ubi-naist/SenStick/ios/SenStickViewer/17091211_1349649568406678_518194324_o.jpg

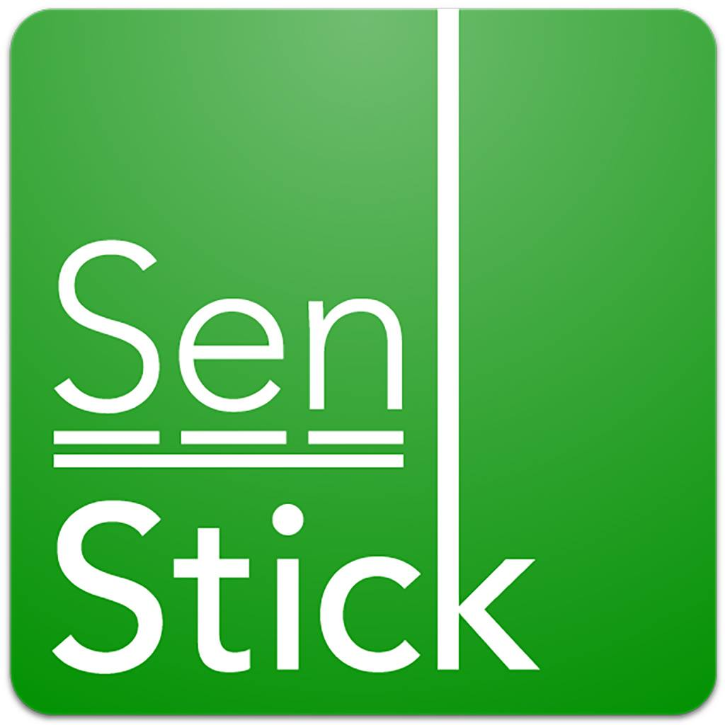
ios/SenStickViewer/17091211_1349649568406678_518194324_o.jpg
