ubi-naist/SenStick/docs/nRF52_SenStick_ハードウェア資料/PWB確認_02.pptx

SenStick3外形寸法

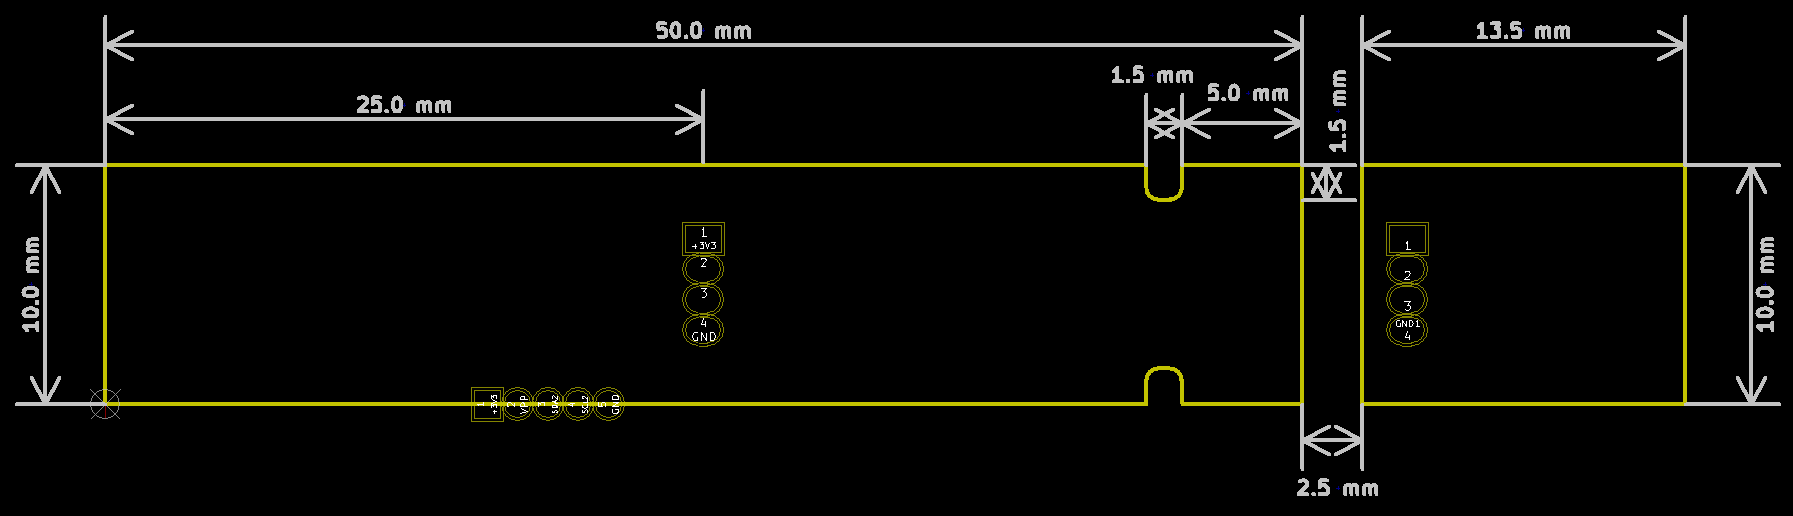
[picture p2: figure]

## Slide 2

SenStick3　全層パターン図

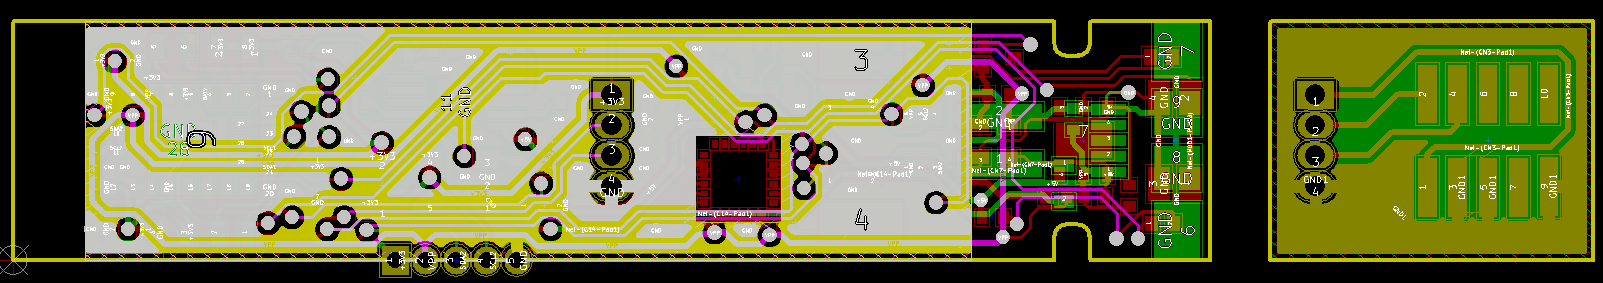
[picture p3: figure]

9軸センサー

温湿度センサー

## Slide 3

SenStick3パターン図

L1:表面

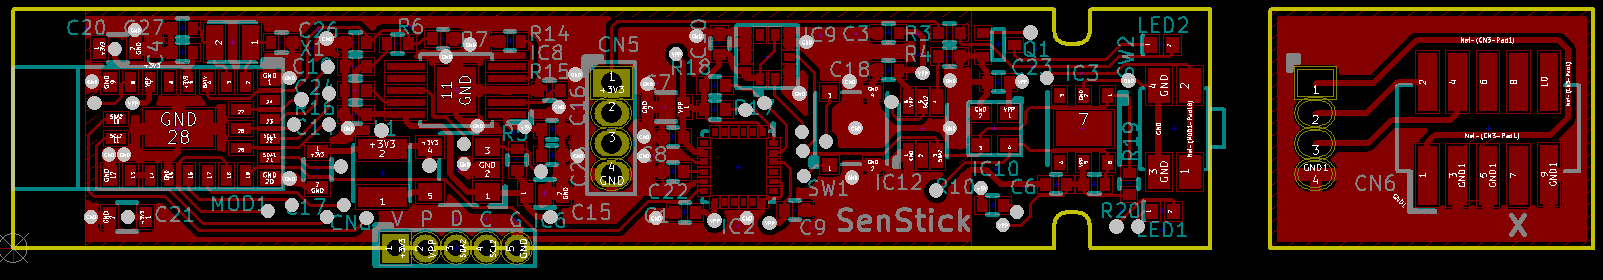
[picture p4: figure]

シルク文字:SenStick　Ver.3 Rev.00

シルク文字:SenStick

L4:裏面

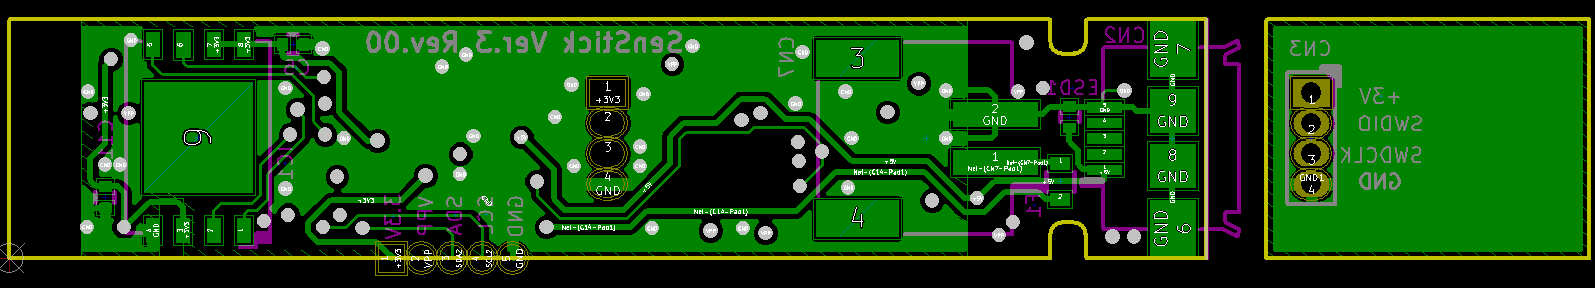
[picture p5: figure]

## Slide 4

SenStick3パターン図

L2:内層(GND)

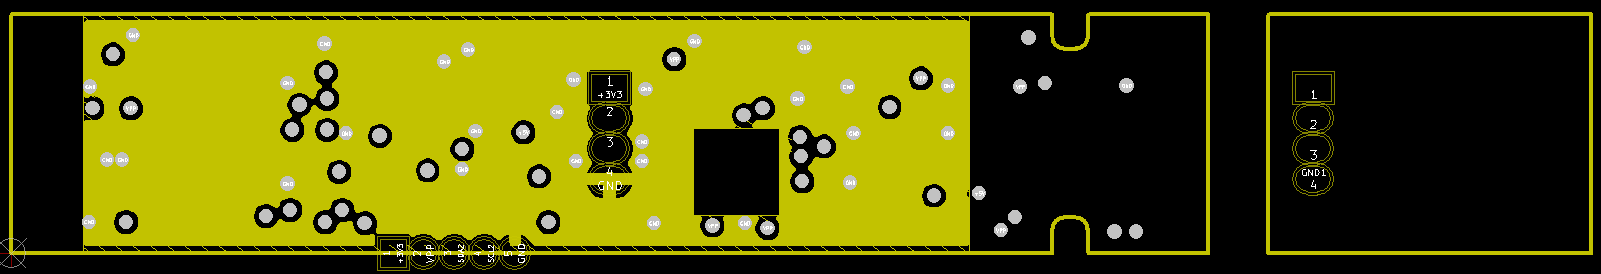
[picture p6: figure]
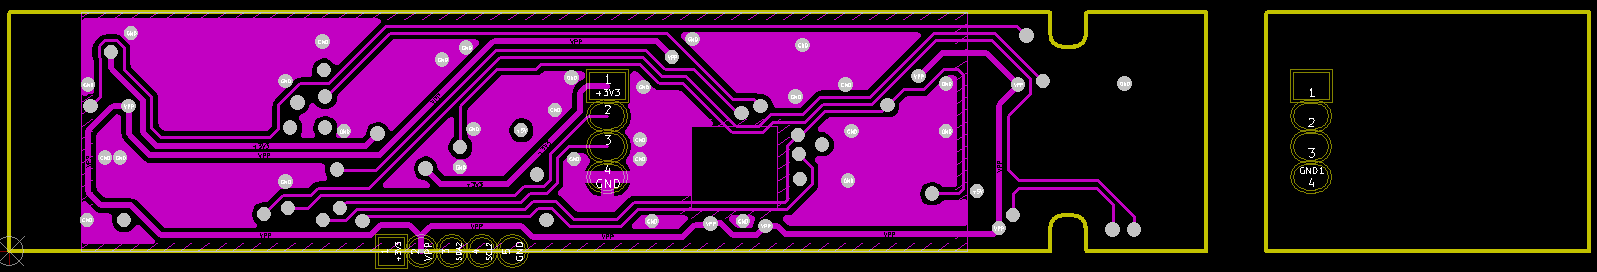
[picture p7: figure]

L3:内層(GND+信号線)
