ubi-naist/SenStick/ios/SenStickViewer/README.md

ビルド時にエラーメッセージが出ます。

'/Users/T_Suzuki/Desktop/Matilde/_arart/_senstick/0704/SenStickViewer/Pods/Target Support Files/EVReflection/EVReflection-prefix.pch' file not found

次のコマンドを実行してください。

$ cd SenStick-firmware/ios/SenStickViewer
$ pod install
