ubi-naist/SenStick/3d_data/case/senstick2/101.Glasses/README.pdf

●3D データ利用に関する注意

この SenStick2 用のメガネケースのメガネの元の 3D データは i.Design Studio が提

供して いるものです。使用(対外的に公開(学会や論文誌等))する際は i.Design Studio

のクレジット を表記してください。

利用に関する詳細は下記サイトを参照してください。
http://www.idesign-s.com/info/eyewear-3d-data/

以上

作成者：金平卓也
作成日：2016/08/09

バージョン：1.00
