ubi-naist/SenStick/docs/nRF52_SenStick_ハードウェア資料/Senstick3_BOM_R00.xlsx

Loc. | Symbol | Footprint | 品名 | 概要 | Sche | 単価 | SIZE | 記事 | QFP | CHIP | DISC
MOD1 | EYSHJNZXZ | EYSHJNZXZ | EYSHJNZXZ | BLE module | EYSHJNZXZ | 1713.1 | 11.3x5.1x1.3 |  | 1 |  |  | http://www.mouser.jp/ProductDetail/Taiyo-Yuden/EYSHJNZXZ/
IC1 | MX25L25635FZ2 | WSON-8L | MX25L25635FZ2I-10G | Flash 256M | MX25L25635FZ2 | 423.6 | 10x10x2.65 |  | 1 |  |  | http://www.digikey.jp/product-detail/ja/macronix/MX25L25635FZ2I-10G/1092-1150-ND/4211591
IC2 | MPU-9250 | MPU-9250 | MPU-9250 | 9D Sensor | MPU-9250 | 655.6 | 3x3x1.1 |  | 1 |  |  | http://www.digikey.jp/product-detail/ja/invensense/MPU-9250/1428-1019-1-ND/4626450
IC3 | SHT-20 | SHT-20 | SHT20 | Tenp/Hum Sensor | SHT-20 | 484.7 | 3x3x1.1 |  | 1 |  |  | http://www.digikey.jp/product-detail/ja/sensirion-ag/SHT20/1649-1004-1-ND/5872286
IC6 | XC9265331MR-G | SOT-25 | XC9265A331MR-G | DC/DC 3.3V | XC9265331MR-G | 110.8 | 2.9x2.8 |  | 1 |  |  | http://www.digikey.jp/product-search/ja/integrated-circuits-ics/pmic-voltage-regulators-dc-dc-switching-regulators/2556570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
IC8 | BQ24090 | HVSSOP10 | BQ24090DGQR | Li-po Charger | BQ24090DGQR | 93.7 | 5x3 |  |  | 1 |  | http://www.digikey.jp/product-detail/ja/texas-instruments/BQ24090DGQR/296-38875-1-ND/5142987
IC9 | LPS25 | HLGA-10L | LPS25HBTR | Pressure Sensors | LPS25HBTR | 276.5 | 2.5x2.5x0.8 |  | 1 |  |  | http://www.mouser.jp/ProductDetail/STMicroelectronics/LPS25HBTR/
IC10 | BH1780 | BH1780 | BH1780GLI-E2 | Light Sensor | BH1780GLI-E2 | 231.1 | 2x2x0.8 |  | 1 |  |  | http://www.mouser.jp/ProductDetail/ROHM-Semiconductor/BH1780GLI-E2/
IC12 | VEML6070 | VEML6070 | VEML6070 | UV Sensor | VEML6070 | 138.2 | 2.35x1.8 |  | 1 |  |  | http://www.mouser.jp/ProductDetail/Vishay/VEML6070/
Q1 | DTC123E | SOT523 | DDTC123EE-7-F | Digi Tr. | DTC123E | 19.8 | 1.6x1.6 |  |  | 1 |  | http://www.digikey.jp/product-detail/ja/diodes-incorporated/DDTC123EE-7-F/DDTC123EE-FDICT-ND/815591
LED1 | LED | SML-P1 | SML-P13BC8TT86 | Blue | Blue | 22.7 | 1x0.6 | 充電中 |  | 1 |  | http://www.mouser.jp/ProductDetail/ROHM-Semiconductor/SMLP13BC8TT86/
LED2 | LED | SML-P1 | SML-P12VTT86R | Red | Red | 12.9 | 1x0.6 | 動作中 |  | 1 |  | http://www.mouser.jp/ProductDetail/ROHM-Semiconductor/SML-P12VTT86R/
ESD1 | TVS | CR1005 | LXES15AAA1-100 | LXES15AAA1-100 | LXES15AAA1 | 42.0 | 1005 | Vbus用 |  | 1 |  | http://www.digikey.jp/product-detail/ja/murata-electronics-north-america/LXES15AAA1-100/490-5680-1-ND/2651839
X1 | Crystal | FC-12M | FC-12M 32.7680KA-A3 | 32.768kHz 20ppm | 32.768kHz | 65.8 | 2.05x1.2 | 推奨部品 |  | 1 |  | http://www.digikey.jp/product-detail/ja/epson/FC-12M-32.7680KA-A3/SER3672CT-ND/2403445
L1 | INDUCTOR | DFE2520 | 1239AS-H-100M=P2 | 10uH | 10u | 27.4 | 2.5x2x1.2 |  |  | 1 |  | http://www.mouser.jp/ProductDetail/Murata/1239AS-H-100M=P2/
F1 | FUSE | CR1608 | FMC16102ABTP | 1A | 1A | 16.9 | 1608 |  |  | 1 |  | http://www.mouser.jp/ProductDetail/Walsin/FMC16102ABTP/
R3 | R | CR1005 | ERJ-2RKF1001X | 1k | 1k | 1.2 | 1005 |  |  | 1 |  | http://www.digikey.jp/product-detail/ja/panasonic-electronic-components/ERJ-2RKF1001X/P1.00KLCT-ND/97341
R4 | R | CR1005 | ERJ-2RKF5603X | 560k | 560k | 1.2 | 1005 |  |  | 1 |  | http://www.digikey.jp/product-detail/ja/panasonic-electronic-components/ERJ-2RKF5603X/P560KLCT-ND/1746704
R5 | R | CR1005 | ERJ-2RKF1003X | 100k | 100k | 1.2 | 1005 |  |  | 1 |  | http://www.digikey.jp/product-detail/ja/panasonic-electronic-components/ERJ-2RKF1003X/P100KLCT-ND/194127
R6 | R | CR1005 | ERJ-2RKF4703X | 470k | 470k | 1.2 | 1005 |  |  | 1 |  | http://www.digikey.jp/product-detail/ja/panasonic-electronic-components/ERJ-2RKF4703X/P470KLCT-ND/1746694
R7 | R | CR1005 | ERJ-2RKF2203X | 220k | 220k | 1.2 | 1005 |  |  | 1 |  | http://www.digikey.jp/product-detail/ja/panasonic-electronic-components/ERJ-2RKF2203X/P220KLCT-ND/1746654
R10 | R | CR1005 | ERJ-2RKF1001X | 1k | 1k | 1.2 | 1005 |  |  | 1 |  | http://www.digikey.jp/product-detail/ja/panasonic-electronic-components/ERJ-2RKF1001X/P1.00KLCT-ND/97341
R14 | R | CR1005 | ERJ-2RKF2001X | 2k | 2k | 1.2 | 1005 |  |  | 1 |  | http://www.digikey.jp/product-detail/ja/panasonic-electronic-components/ERJ-2RKF2001X/P2.00KLCT-ND/194233
R15 | R | CR1005 | ERJ-2RKF2202X | 22k | 22k | 1.2 | 1005 |  |  | 1 |  | http://www.digikey.jp/product-detail/ja/panasonic-electronic-components/ERJ-2RKF2202X/P22.0KLCT-ND/1746653
R16 | R | CR1005 | ERJ-2RKF1002X | 10k | 10k | 1.2 | 1005 |  |  | 1 |  | http://www.digikey.jp/product-detail/ja/panasonic-electronic-components/ERJ-2RKF1002X/P10.0KLCT-ND/194119
R17 | R | CR1005 | ERJ-2RKF1002X | 10k | 10k | 1.2 | 1005 | I2C Pullup |  | 1 |  | http://www.digikey.jp/product-detail/ja/panasonic-electronic-components/ERJ-2RKF1002X/P10.0KLCT-ND/194119
R18 | R | CR1005 | ERJ-2RKF1002X | 10k | 10k | 1.2 | 1005 | I2C Pullup |  | 1 |  | http://www.digikey.jp/product-detail/ja/panasonic-electronic-components/ERJ-2RKF1002X/P10.0KLCT-ND/194119
R19 | R | CR1005 | ERJ-2RKF1002X | 10k | 10k | 1.2 | 1005 | I2C Pullup |  | 1 |  | http://www.digikey.jp/product-detail/ja/panasonic-electronic-components/ERJ-2RKF1002X/P10.0KLCT-ND/194119
R20 | R | CR1005 | ERJ-2RKF1002X | 10k | 10k | 1.2 | 1005 | I2C Pullup |  | 1 |  | http://www.digikey.jp/product-detail/ja/panasonic-electronic-components/ERJ-2RKF1002X/P10.0KLCT-ND/194119
C1 | C | CR1005 | GRM155R71C104KA88J | 0.1uF | 0.1u | 0.6 | 1005 |  |  | 1 |  | http://www.digikey.jp/product-detail/ja/murata-electronics-north-america/GRM155R71C104KA88J/490-6328-1-ND/3845525
C3 | C | CR1005 | GRM155R71C104KA88J | 0.1uF | 0.1u | 0.6 | 1005 |  |  | 1 |  | http://www.digikey.jp/product-detail/ja/murata-electronics-north-america/GRM155R71C104KA88J/490-6328-1-ND/3845525
C4 | C | CR1005 | GRM155R71C104KA88J | 0.1uF | 0.1u | 0.6 | 1005 |  |  | 1 |  | http://www.digikey.jp/product-detail/ja/murata-electronics-north-america/GRM155R71C104KA88J/490-6328-1-ND/3845525
C5 | C | CR1005 | GRM155R71C104KA88J | 0.1uF | 0.1u | 0.6 | 1005 |  |  | 1 |  | http://www.digikey.jp/product-detail/ja/murata-electronics-north-america/GRM155R71C104KA88J/490-6328-1-ND/3845525
C6 | C | CR1005 | GRM155R71C104KA88J | 0.1uF | 0.1u | 0.6 | 1005 |  |  | 1 |  | http://www.digikey.jp/product-detail/ja/murata-electronics-north-america/GRM155R71C104KA88J/490-6328-1-ND/3845525
C7 | C | CR1608 | GRM188R60J106ME47J | 10uF | 10u | 5.5 | 1608 |  |  | 1 |  | http://www.digikey.jp/product-detail/ja/murata-electronics-north-america/GRM188R60J106ME47J/490-6405-1-ND/3845602
C8 | C | CR1005 | GRM155R60J475ME47D | 4.7uF/6.3V | 4.7u | 5.0 | 1005 |  |  | 1 |  | http://www.digikey.jp/product-detail/ja/murata-electronics-north-america/GRM155R60J475ME47D/490-5915-1-ND/3719860
C9 | C | CR1005 | GRM155R71C104KA88J | 0.1uF | 0.1u | 0.6 | 1005 |  |  | 1 |  | http://www.digikey.jp/product-detail/ja/murata-electronics-north-america/GRM155R71C104KA88J/490-6328-1-ND/3845525
C10 | C | CR1005 | GRM155R60J105KE19D | 1uF/6.3V | 1u | 1.1 | 1005 |  |  | 1 |  | http://www.digikey.jp/product-detail/ja/murata-electronics-north-america/GRM155R60J105KE19D/490-1320-1-ND/587919
C11 | C | CR1005 | GRM155R60J475ME47D | 4.7uF/6.3V | 4.7u | 5.0 | 1005 |  |  | 1 |  | http://www.digikey.jp/product-detail/ja/murata-electronics-north-america/GRM155R60J475ME47D/490-5915-1-ND/3719860
C14 | C | CR1005 | GRM188R60J226MEA0D | 2.2uF | 2.2u | 10.2 | 1005 |  |  | 1 |  | http://www.digikey.jp/product-detail/ja/murata-electronics-north-america/GRM155R61A225KE95D/490-10451-1-ND/5026361
C15 | C | CR1608 | GRM188R60J106ME47J | 10uF | 10u | 5.5 | 1608 |  |  | 1 |  | http://www.digikey.jp/product-detail/ja/murata-electronics-north-america/GRM188R60J106ME47J/490-6405-1-ND/3845602
C16 | C | CR1005 | GRM155R71C104KA88J | 0.1uF | 0.1u | 0.6 | 1005 |  |  | 1 |  | http://www.digikey.jp/product-detail/ja/murata-electronics-north-america/GRM155R71C104KA88J/490-6328-1-ND/3845525
C17 | C | CR1608 | GRM188R60J226MEA0D | 22uF | 22u | 10.2 | 1608 |  |  | 1 |  | http://www.digikey.jp/product-detail/ja/murata-electronics-north-america/GRM188R60J226MEA0D/490-7611-1-ND/4280544
C18 | C | CR1005 | GRM155R71C104KA88J | 0.1uF | 0.1u | 0.6 | 1005 |  |  | 1 |  | http://www.digikey.jp/product-detail/ja/murata-electronics-north-america/GRM155R71C104KA88J/490-6328-1-ND/3845525
C19 | C | CR1005 | GRM155R71H103KA88D | 0.01uF | 0.01u | 0.5 | 1005 |  |  | 1 |  | http://www.digikey.jp/product-detail/ja/murata-electronics-north-america/GRM155R71H103KA88D/490-4516-1-ND/1033275
C20 | C | CR1608 | GRM188R60J106ME47J | 10uF | 10u | 5.5 | 1608 |  |  | 1 |  | http://www.digikey.jp/product-detail/ja/murata-electronics-north-america/GRM188R60J106ME47J/490-6405-1-ND/3845602
C21 | C | CR1608 | GRM188R60J106ME47J | 10uF | 10u | 5.5 | 1608 |  |  | 1 |  | http://www.digikey.jp/product-detail/ja/murata-electronics-north-america/GRM188R60J106ME47J/490-6405-1-ND/3845602
C22 | C | CR1005 | GRM155R71C104KA88J | 0.1uF | 0.1u | 0.6 | 1005 |  |  | 1 |  | http://www.digikey.jp/product-detail/ja/murata-electronics-north-america/GRM155R71C104KA88J/490-6328-1-ND/3845525
C23 | C | CR1005 | GRM155R71C104KA88J | 0.1uF | 0.1u | 0.6 | 1005 |  |  | 1 |  | http://www.digikey.jp/product-detail/ja/murata-electronics-north-america/GRM155R71C104KA88J/490-6328-1-ND/3845525
C24 | C | CR1005 | GRM155R60J105KE19D | 1uF/6.3V | 1u | 1.1 | 1005 |  |  | 1 |  | http://www.digikey.jp/product-detail/ja/murata-electronics-north-america/GRM155R60J105KE19D/490-1320-1-ND/587919
C25 | C | CR1005 | GRM155R60J105KE19D | 1u/6.3V | 1u | 1.1 | 1005 |  |  | 1 |  | http://www.digikey.jp/product-detail/ja/murata-electronics-north-america/GRM155R60J105KE19D/490-1320-1-ND/587919
C26 | C | CR1005 | C1005CH1H150J050BA | 15pF | 15p | 1.9 | 1005 | RTC 32kHz X7tal用 |  | 1 |  | http://www.digikey.jp/product-detail/ja/tdk-corporation/C1005CH1H150J050BA/445-10834-1-ND/3952500
C27 | C | CR1005 | C1005CH1H150J050BA | 15pF | 15p | 1.9 | 1005 | RTC 32kHz X7tal用 |  | 1 |  | http://www.digikey.jp/product-detail/ja/tdk-corporation/C1005CH1H150J050BA/445-10834-1-ND/3952500
CN2 | USB-micro-B | 10104110 | 10104110-0001LF | microUSB | 10104110-0001LF | 58.8 | 7.5x5x2.6 |  |  | 1 |  | http://www.mouser.jp/ProductDetail/FCI-Amphenol/10104110-0001LF/
CN3 | CONN_01X04 | XB-1-4PIN | 1.27mm pich | COCNON-N4NPI-N4PIN | Pinheader | 5.7 |  | 書き込み基板側 |  |  | 1 | https://www.systemgear.jp/product_info.php?manufacturers_id=27&products_id=46135
CN5 | CONN_01X04 | XB-1-4PIN | 1.27mm pich | 4ピンコネクタ端子 | TH_only | 0.0 |  | Programming用 THのみ
CN6 | CONN_02X05 | 5x2_1.27 | 1.27mm pich | 2x5_SEGGER_9pin | Pinheader | 96.5 |  | 書き込み基板側 |  | 1 |  | http://www.digikey.jp/product-detail/ja/harwin-inc/M50-3600542/952-1389-ND/2264370
CN7 | CONN_01X02 | S2B-PH | S2B-PH-SM4-TB(LF)(SN) | S2B-PH-SM4-TB | S2B-PH | 46.0 | 7.9x8.6x5.5 | Li-poバッテリー用 |  | 1 |  | http://www.digikey.jp/product-detail/ja/jst-sales-america-inc/S2B-PH-SM4-TB(LF)(SN)/455-1749-1-ND/926846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
CN8 | CONN_01X04 | TP1.27-4P | 1.27mm pich | 4ピンコネクタ端子 | I2C_2 | 0.0 |  | I2C_2用 THのみ
SW1 | SW_PUSH | SKSMAFE010 | SKSMAFE010 | RESET SW | SKSMAFE010 | 44.8 | 3.4x2.9x1 | 暫定 |  | 1 |  | http://www.mouser.jp/ProductDetail/ALPS/SKSMAFE010/
SW2 | SW_PUSH | SKSCLAE010 | SKSCLAE010 | POWER SW | SKSCLAE010 | 30.6 | 3.85x4.55x1.1 | 暫定 |  | 1 |  | http://www.mouser.jp/ProductDetail/ALPS/SKSCLAE010/
BATT3 |  |  | ??? | 3.7V,40mAh,Li-po |  | 800.0 |  | 暫定 |  |  |  | https://www.sparkfun.com/products/13852
 |  |  |  |  |  | 5498.5 |  | 部品代合計 | 8 | 50 | 1
PWB1 |  |  |  | PWB |  |  |  | 4層 1枚にまとめる
Mount |  |  |  | 実装費用 |  |  |  | 印刷マスク、実装費用
