ubi-naist/SenStick/3d_data/case/basic_case_for_senstick3.stl

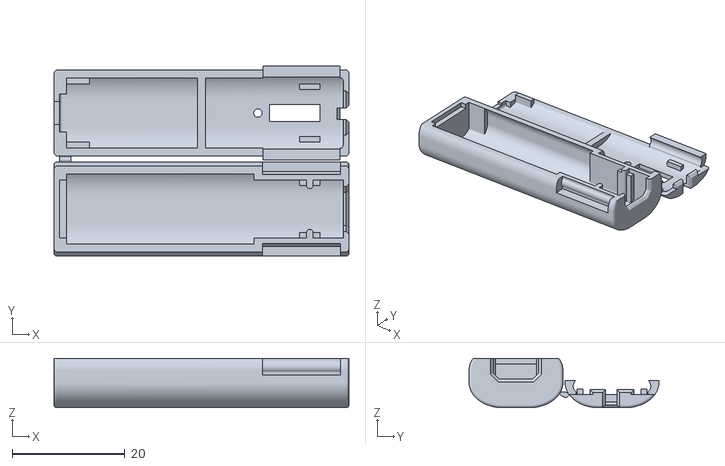
[picture p29: CAD file, 2017-03-04]
3d_data/case/basic_case_for_senstick3.stl
52.2 x 33.7 x 8.75
