ubi-naist/SenStick/3d_data/case/senstick2/100.Basic/stl/cover_for_basic.stl

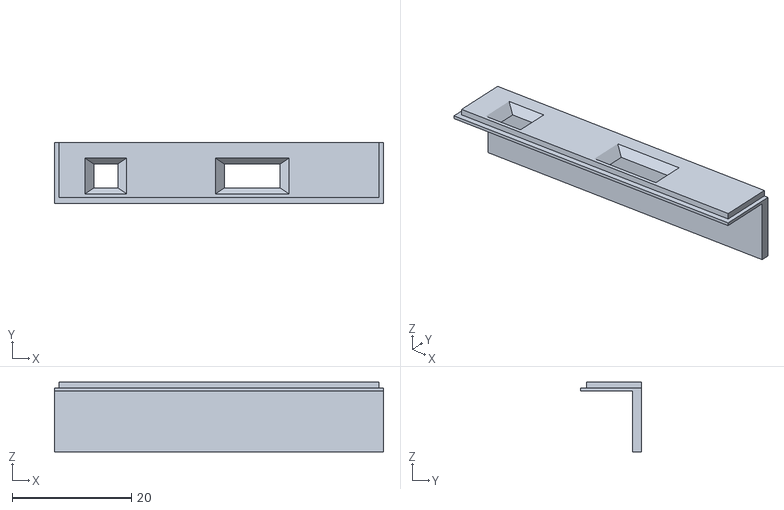
[picture p30: CAD file, 2016-08-29]
3d_data/case/senstick2/100.Basic/stl/cover_for_basic.stl
55.2 x 10.3 x 11.8
