ubi-naist/SenStick/3d_data/case/senstick2/101.Glasses/stl/button.stl

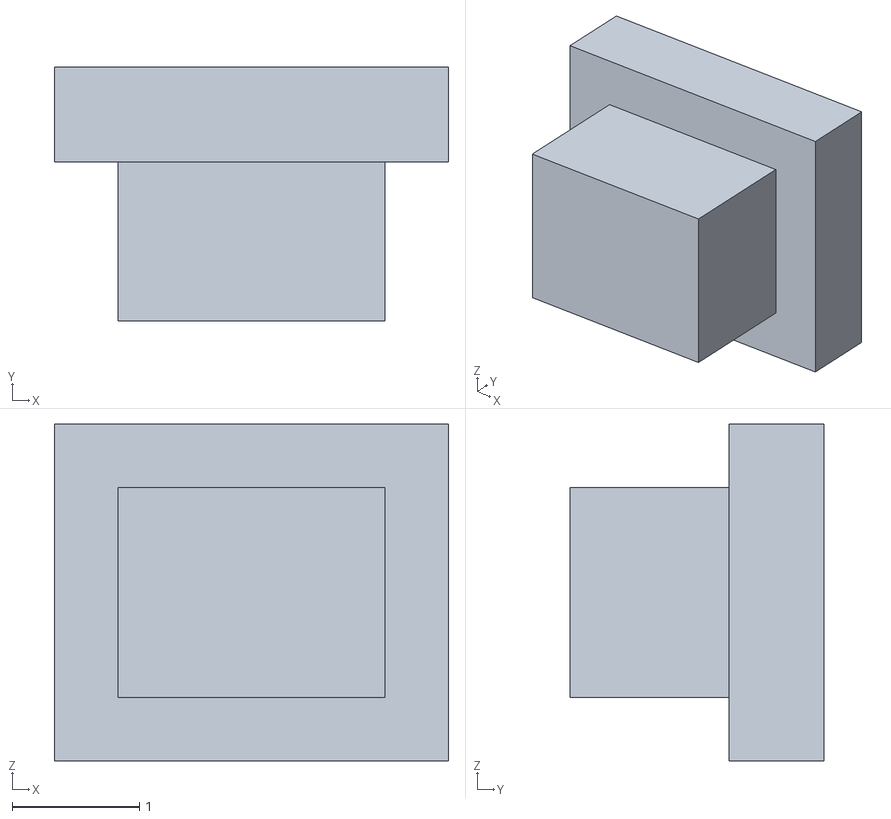
[picture p31: CAD file, 2016-08-29]
3d_data/case/senstick2/101.Glasses/stl/button.stl
3.10 x 2.00 x 2.65
