ubi-naist/SenStick/3d_data/case/senstick2/200.Flat/stl/body_for_flat.stl

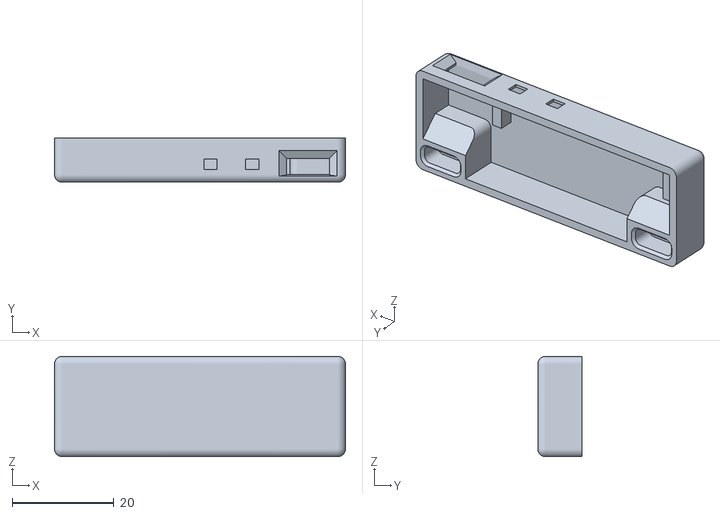
[picture p32: CAD file, 2016-08-29]
3d_data/case/senstick2/200.Flat/stl/body_for_flat.stl
57.2 x 8.75 x 19.7
