ubi-naist/SenStick/3d_data/circuit_board/senstick2/stl/senstick2_sub_circuit.stl

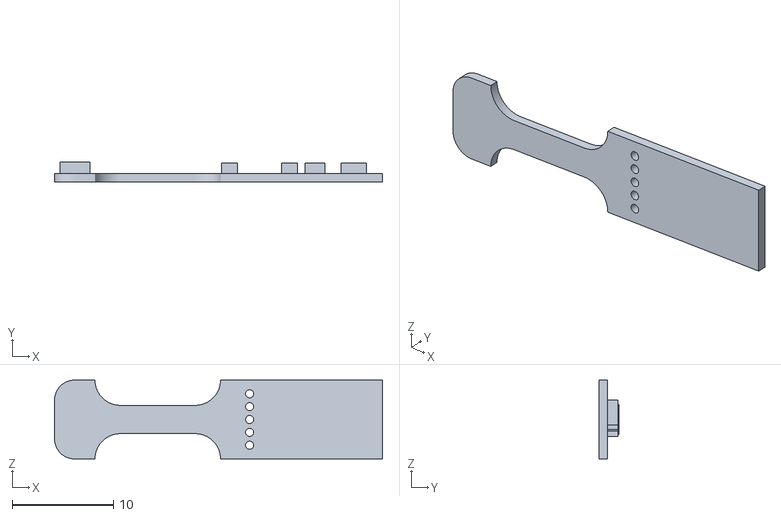
[picture p33: CAD file, 2016-09-01]
3d_data/circuit_board/senstick2/stl/senstick2_sub_circuit.stl
32.4 x 1.95 x 7.80
