ubi-naist/SenStick/3d_data/case/senstick2/101.Glasses/stl/body_for_basic_non_log.stl

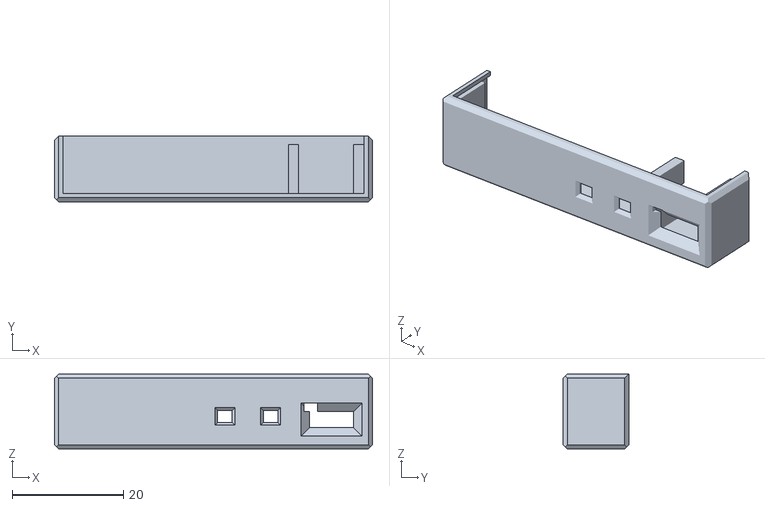
[picture p34: CAD file, 2016-08-29]
3d_data/case/senstick2/101.Glasses/stl/body_for_basic_non_log.stl
57.2 x 11.8 x 13.5
