ubi-naist/SenStick/3d_data/case/senstick2/102.Chopstick/stl/body_for_chopstick.stl

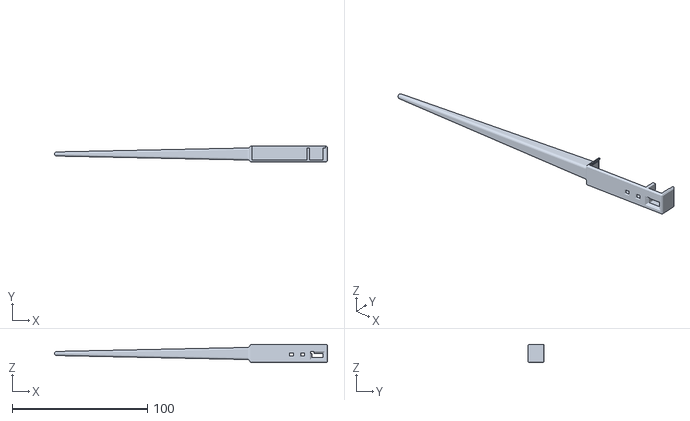
[picture p35: CAD file, 2016-08-29]
3d_data/case/senstick2/102.Chopstick/stl/body_for_chopstick.stl
201.5 x 11.8 x 13.5
