ubi-naist/SenStick/3d_data/case/senstick2/104.Strap/stl/body_for_strap.stl

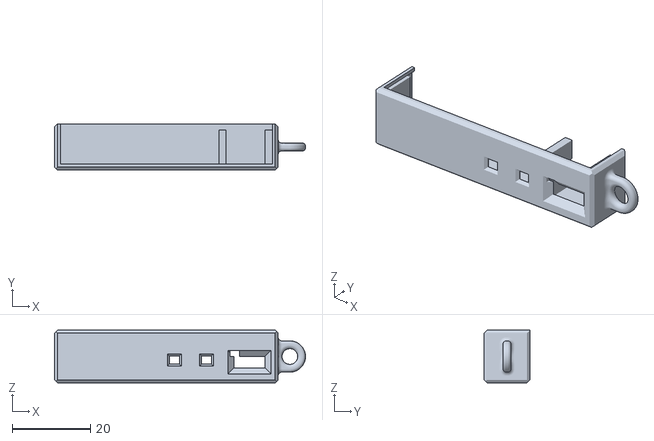
[picture p36: CAD file, 2016-08-29]
3d_data/case/senstick2/104.Strap/stl/body_for_strap.stl
64.2 x 11.8 x 13.5
