ubi-naist/SenStick/3d_data/case/senstick2/300.SuperFlat/stl/cover_for_super_flat.stl

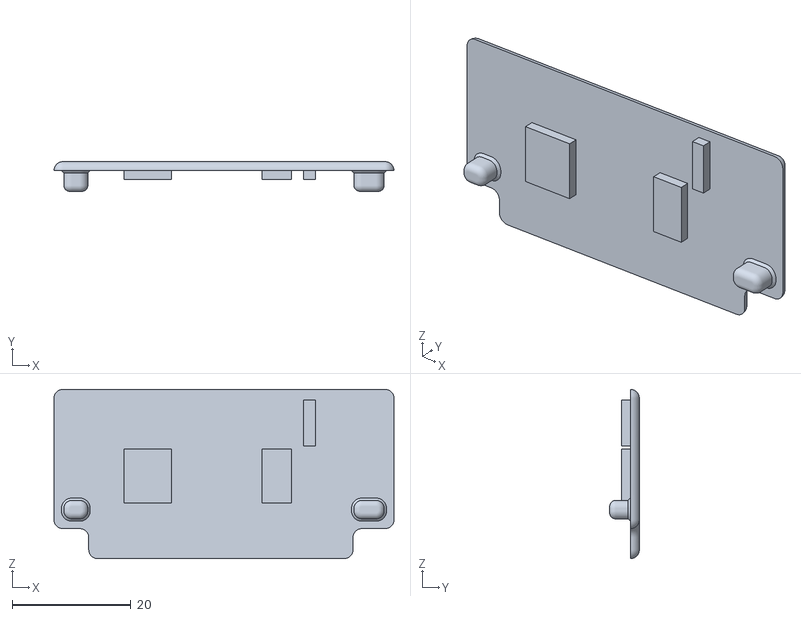
[picture p37: CAD file, 2016-08-29]
3d_data/case/senstick2/300.SuperFlat/stl/cover_for_super_flat.stl
57.2 x 5.00 x 28.5
