ubi-naist/SenStick/3d_data/circuit_board/senstick2/stl/hl-350735.stl

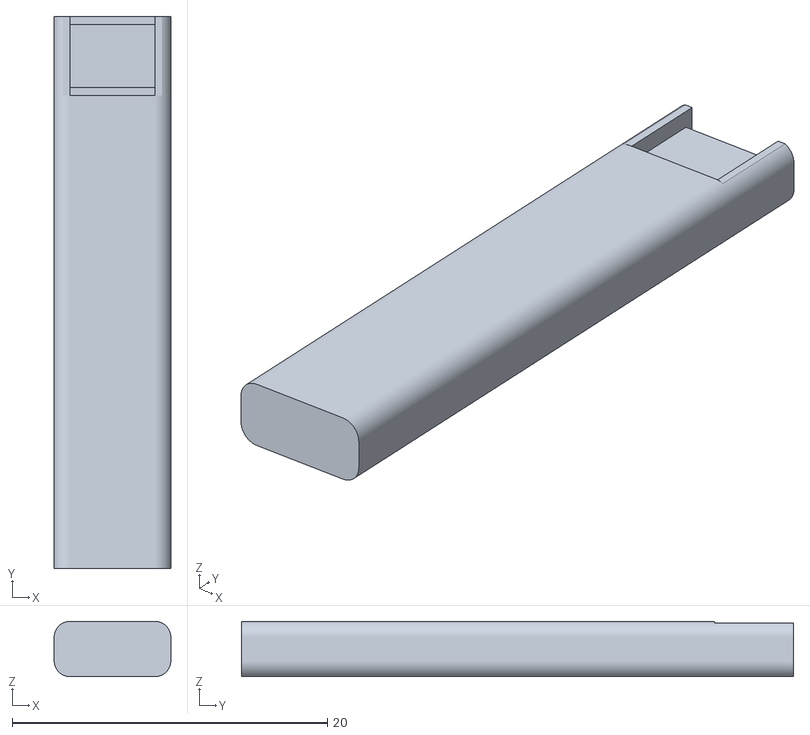
[picture p38: CAD file, 2016-09-01]
3d_data/circuit_board/senstick2/stl/hl-350735.stl
7.40 x 35.0 x 3.50
