ubi-naist/SenStick/3d_data/case/senstick2/103.Ring/stl/base_for_ring.stl

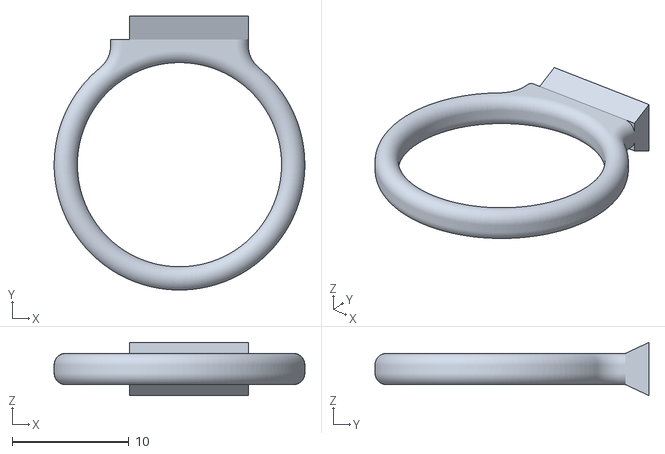
[picture p39: CAD file, 2016-08-29]
3d_data/case/senstick2/103.Ring/stl/base_for_ring.stl
21.5 x 23.5 x 4.57
