ubi-naist/SenStick/3d_data/case/senstick2/200.Flat/stl/cover_for_flat.stl

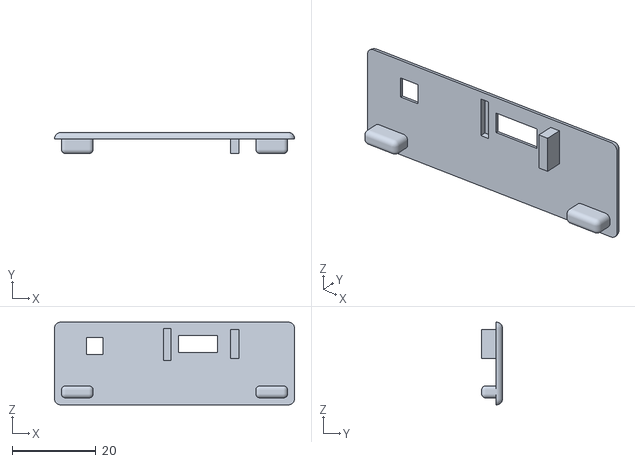
[picture p40: CAD file, 2016-08-29]
3d_data/case/senstick2/200.Flat/stl/cover_for_flat.stl
57.2 x 5.00 x 19.7
