ubi-naist/SenStick/3d_data/case/senstick2/103.Ring/stl/body_for_ring.stl

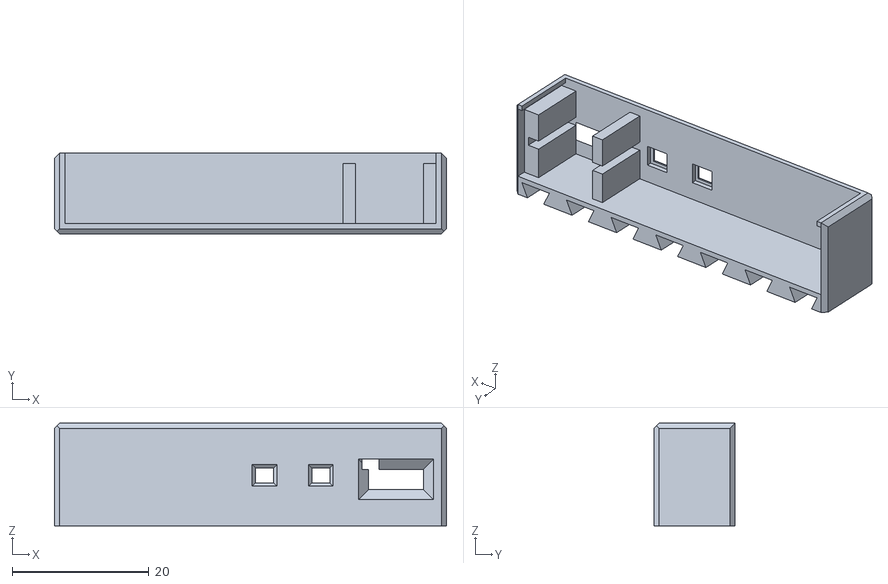
[picture p42: CAD file, 2016-08-29]
3d_data/case/senstick2/103.Ring/stl/body_for_ring.stl
57.2 x 11.8 x 15.0
