ubi-naist/SenStick/binary/revision_history.txt

rev 1.04 2016年9月4日
	・ストレージの割り振りを、加速度/角速度/磁気 10に対し、その他を1とした。
	・加速度/角速度/磁気のサンプリング周期を20ミリ秒、その他を200ミリ秒とした時、9時間記録できる。
	・[bug fix]ストレージ末尾到達でストレージフルになるコードを実装した。
	・[bug fix]デバイス名の変更が、アドバタイジング・パケットのローカルネームに反映される。
	・[bug fix]ログ読み出し中に、ログ読み出しを開始するとファームが落ちる。

rev 1.03 2016年8月24日
	・ センサ周期20ミリ秒化。
	・ ファームのサンプリング周期のデフォルト値を、300ミリ秒から200ミリ秒に変更。
    
	ファーム実装:
	・ センサ取得をTIMER2割り込みに。ログ吐き出しはスケジューラで実行。
	・ センサデータをメイルボックス経由に。

rev 1.02 2016年6月25日
	・デバイス名の編集機能を追加。
	・[fix]ログ読み出しの終端パケットが送信されないバグ。
	       nRF51の6つのパケット境界でちょうどログ送信が完了した時、終端が送られなかった。

rev 1.01 2016年6月4日
	・ロギング中にログ読出するとが例外で落ちるバグを修正。
	rev 1.01-pana
		・パナソニック改造機版向けの暫定ファームウェア。
		・電源電圧管理を無効化している。

rev 1.00 2016年5月29日 
	・初版
