ubi-naist/SenStick/(threads)

Thread 1 (2016-05-31):

照度センサの値が0の時がある。

reinforce-lab, 2016-05-31:
加速度を100ミリ秒で20分取得、その後照度を1秒周期で有効にしてログ取り開始すると、照度の値がゼロ。

reinforce-lab, 2016-08-30:
この時点のSenStickのファームウェアは、加速度のセンサデータの取得周期は、200ミリ秒以上でなければならない。照度センサーは数十ミリ秒I2Cバスを握るため、照度センサーが有効だと、加速度センサーは100ミリ秒周期では動作できない。
SDK側でサンプリング周期が200ミリ秒以下にならないように制限をしていたけれども、それが抜けていた?
ファームのこの周期の制限は、ファーム ver1.0.3で修正している。
942eb546

Closed 2016-08-30.

Thread 4 (2016-08-04):

ファーム更新ができない

reinforce-lab, 2016-08-04:
iPhoneの電源をOn/Offすると、更新できたりする。
連続してデバイスのファーム更新をしようとすると失敗する。
disServiceChangedあたりの手抜きゆえ?

reinforce-lab, 2016-08-30:
DFU時のMACアドレスを、完全にランダムな値にしてみては?

reinforce-lab, 2017-01-26:
原因は、iOSアプリ側のDFU実装ミス。
デバイスにDFUモードのコマンドを書き込むと、デバイスはBLE接続を切断して、DFUモードで再起動する。
iOSアプリは、DFUモードのコマンドを書き込み処理をして、直ちにBLE接続の切断処理を呼び出していた。
iOSアプリ実装の意図では、DFUモードのコマンド書き込みが完了してから、BLE切断処理に進むだろうと、処理がスタックされる想像をしていた。
実際には、処理の早い最新機種では、コマンド書き込みはされず、BLE接続の切断処理がなされる。
このため、コマンドが書き込まれないのだから、デバイスはDFUモードにはならない。
このため、iOSアプリからのファーム更新が失敗する。

Closed 2017-01-26.

Thread 6 (2016-08-18):

Androidから接続すると振る舞いがおかしくなる

reinforce-lab, 2016-08-18:
Androidから接続、
1秒周期でLED点灯、
iOSアプリで接続、接続はできる、センサーデータ取得ができない、デバイス名が空欄、HW/SWバージョンは表示される
電源リセットをかけても同じ

reinforce-lab, 2016-08-30:
ある1つのSenStickで生じた問題。その問題が生じた個体がないと振る舞い確認ができない。到着待ち。

wildriver, 2016-08-30:
この個体、その後、ファームがアップデートできまして、正常に戻りました。なぜその現象になったのかは不明のままです。

Closed 2016-09-01.

Thread 8 (2016-08-18):

デバイスを分離したログファイル保存。

reinforce-lab, 2016-08-18:
話は変わるのですが，
現状:
複数のSenStickを使うと，iOSアプリ内で上書きされていく。
SenStick X のlog0がSenStick Yのlog0で上書きされる．

実装:
Senstickのデバイス情報サービスのシリアル番号でディレクトリを作ってその中にCSVを吐く。
ついでにCSVファイルもセンサ別ではなく，YYMMDDhhmmss.csvみたいな形にして，
1センシング1ファイルすることは可能でしょうか？
取得してないセンサに関しては，Nullを入れて，カラム数固定でCSVを作る感じ。

reinforce-lab, 2016-09-01:
651a7a533

Closed 2016-09-01.

Thread 9 (2016-09-02):

キャラクタリスティクスのUUIDがセンサ種別ごとに割り振られている

reinforce-lab, 2016-09-02:
センサーごとにキャラクタリスティクスUUIDの末尾が異なるが、センサ種別はサービスUUIDで区別していて、キャラクタリスティクスの振る舞いはほぼ同じなのだから、キャラクタリスティクスのUUIDをセンサ種別ごとに異なる値にする必要はない。
センサ種別ごとにサービスUUIDを割り振る、その下の機能としてのキャラクタリスティクスは、UUIDは同じものを割り振る、に。

reinforce-lab, 2017-01-29:
これ、どっちでもいいし、どっちかにしておけばいい話だから、どっちでもいいのだろうと思う。
とりあえず、クローズで。使いづらかったら、次回のファームの開発時のレビューで、誰かが指摘するだろう。

Closed 2017-01-29.

Thread 12 (2016-09-14):

モーション系センサのログデータが取れない

reinforce-lab, 2016-09-14:
全センササンプリング周期は300ミリ秒、モーション系3つをリアルタイム表示でデータ表示がされる。
ログデータ取得画面で、モーション系センサのアイコンがグレーアウト、その他のセンサーのアイコンはハイライト。
ファームバージョン1.02。

reinforce-lab, 2017-01-29:
問題が起きているのは特定のハード1つ。ファーム1.0.6で動作を見たが、普通に動いている。

Closed 2017-01-29.

Thread 13 (2016-12-01):

SDKあれこれ手直し

reinforce-lab, 2016-12-01:
Byteってかっこ悪い。UInt8で置換しときます...
enumでいちいちCustomStringConv定義してるの、うざったい。Swift3で文字列変換してくれるので、削っときます...
rotocol _UInt8Type { }
extension UInt8: _UInt8Type {}
extension Array where Element : _UInt8Type {
    func toHexString() -> String
とかの制約って、Swift3.1で Element == UInt8 って書けるようになっている。Xcode8.1はSwift3.01なので、3.1が来たら修正します。

Thread 16 (2016-12-28):

NotificationでCCCDの読み出しができない

reinforce-lab, 2016-12-28:
Linux系のNode-Redで使用しているnobleが、notificationの設定で、cccdを読み込んでから書き込みする。
しかしSenstickのcccdは読み込み処理で何も返ってこない。センサータグはそれが返ってくる。

おそらく: cccdのリードパーミションをつけていないから? ->つけろ。

reinforce-lab, 2017-01-26:
issue #20 と内容が同じなので、これはクローズ。

Closed 2017-01-26.

Thread 17 (2016-12-28):

センサーのデータ保存をしていないのに、メタデータだけ増えていく

reinforce-lab, 2016-12-28:
生データをBLEで流すのと、フラッシュの保存、その2つの処理があるからうんぬんなファーム内部の都合で、フラッシュ保存する/しないフラグを入れるのが、めんどくさかった...

バグです。

reinforce-lab, 2017-01-29:
内部構造が、フラッシュへの記録をしないことを前提としてないで作っちゃっていて、今のファームで修正するのは結構大変。次のバージョンのファームで更新するようにする。

reinforce-lab, 2017-01-29:
9afc194c0
修正。

Closed 2017-01-29.

Thread 18 (2017-01-04):

磁気センサが反応してない

wildriver, 2017-01-04:
12月27日に，SenStick3とiOSアプリを繋いでみたところ，磁気センサのグラフが横棒のまま変化しない．

reinforce-lab, 2017-01-26:
054e032 I2Cの速度は100kHzにすることで、磁気センサーが動くようになりました。

nRF52版では、I2Cの通信速度を400kHzに設定すると、磁気センサーの値が取れません。nRF51版では400kHzで動いていたのですが。
nRF52版でも100kHzにすれば、磁気センサーが動きます。センサからの情報取得としては、100kHzでよいのですが、早いに越したことはなかろうと、センサが対応する上限の400kHzに設定していました。

Closed 2017-01-26.

Thread 20 (2017-01-11):

node.jsの対応

reinforce-lab, 2017-01-11:
linuxでのnode.jsの動作確認。
nRF52 SDK12だと動くが、nRF51 SDK10だと動かない。
linuxでのnode.jsでは、CCCDの読み込みのち書き込み、読み込み属性がないためATTで停止、切断をしているのでは?
対応: SDK12に変更する。SDK10でCCCDの読み込み属性をつける。

reinforce-lab, 2017-01-26:
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
SDK10のコードで、センサのリアルタイムデータのキャラクタリスティクスの追加処理を見ている限り、ノーティフィケーションとインディケーションの場合はCCCDのリードパーミションを開いている。

対処 -> 実際のファームのBLEのATTを読み出して、CCCDのリードパーミションを確認する。

reinforce-lab, 2017-01-29:
nRF Connectで、nRF51版のcccdを読み出そうとすると、gatt timeout。nRF52版だと読み出せる。
たしかに、cccdが読み出せない振る舞い。

reinforce-lab, 2017-01-30:
SDK10ではCCCD読み出しで通信が停止する。SDK12にすれば解決するが、nRF51は16kBで今回の実装ではメモリが足りず、実装無理。

Closed 2017-01-30.

Thread 21 (2017-01-28):

nrf51版、スリープ時の消費電流が0.3mAと、大きすぎる

reinforce-lab, 2017-01-28:

reinforce-lab, 2017-01-30:
原因わからず。

Product spec.をみると、300uAの消費電流は、32MHzクロックを分周した1MHzクロックでタイマーが動作している場合の値。だからTIMER2が動作したままになっている可能性が考えうる。他にはチップのバグ。

nRF51版は、CEAAE00 rev3。エラッタをみてもTIMERやRTC周りでの消費電流増加バグは解決されている。ただしLFCLKSRCを設定する前にRTCレジスタに書き込むと1mA消費電流が増えるバグ(#72)が新たに発生している。

最新版のSDKだと解消している可能性もあるけれども、メモリが16kBでは、絶望的に足りない。
32kB版のもじゅーるなら、S130でSDK12でnRF52版と開発環境を揃えられたのだろうけど、このメモリ量で今回のGATTSの多さでは、メモリが足りなくて実装不可能。

未解決として、放置。

Closed 2017-01-30.

Thread 27 (2017-04-19):

レンジ設定不要のセンサーの、設定画面にレンジ表示が出ている。

reinforce-lab, 2017-04-19:
レンジ設定部分の表示を隠すこと。

reinforce-lab, 2017-04-19:
SDK、クラスのメソッドのオーバーライドのコンパイルエラー。対処方法の参考:
http://stackoverflow.com/questions/34585689/overriding-generic-function-error-in-swift

reinforce-lab, 2017-05-19:
81c540ac

Closed 2017-05-19.

Thread 31 (2017-10-17):

電源が入らない

ZinNyeinOo, 2017-10-17:
USBケーブルで、充電をし、青色LEDが消灯後、操作スイッチを押しても電源が入りません。
2ヶ月ほど前までは正常に動作していました。
何か対処方法をご存知の方いらっしゃいますでしょうか？

reinforce-lab, 2017-10-17:
ファームを作っているものです。

もしかすると、電池が充電できない状態になっていると、そのような状態になるかもしれません。
ものすごくぼんやりとした考えですが、充電ICは動作しているけど、電池両端電圧が回路の起動電圧3.0Vまで上がらない、くらいかなと思うのです。
電池を交換してみてみる、はあるかなと思います。

もしも時間があれば、郵送してもらえれば、確認できるかもです。

wildriver, 2017-10-18:
ちなみに，電池は一般的なJST PH型 2ピンコネクタのものなら交換可能です．
例：https://www.switch-science.com/catalog/3166/
