ubi-naist/SenStick/docs/nRF52_SenStick_ハードウェア資料/SenStick3_sche_01.pdf

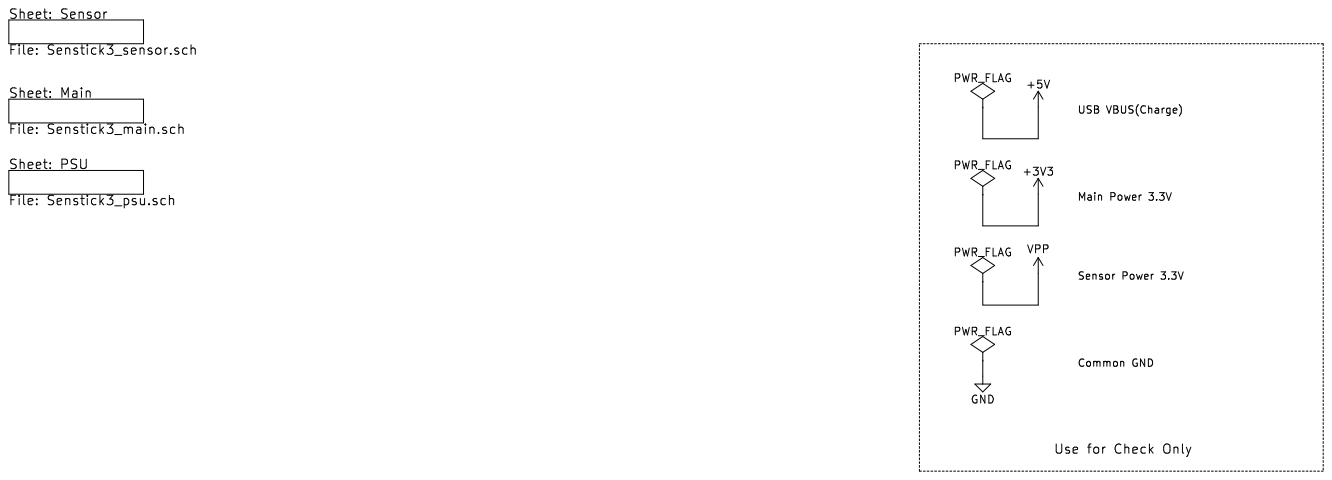
[picture p43: page 1]

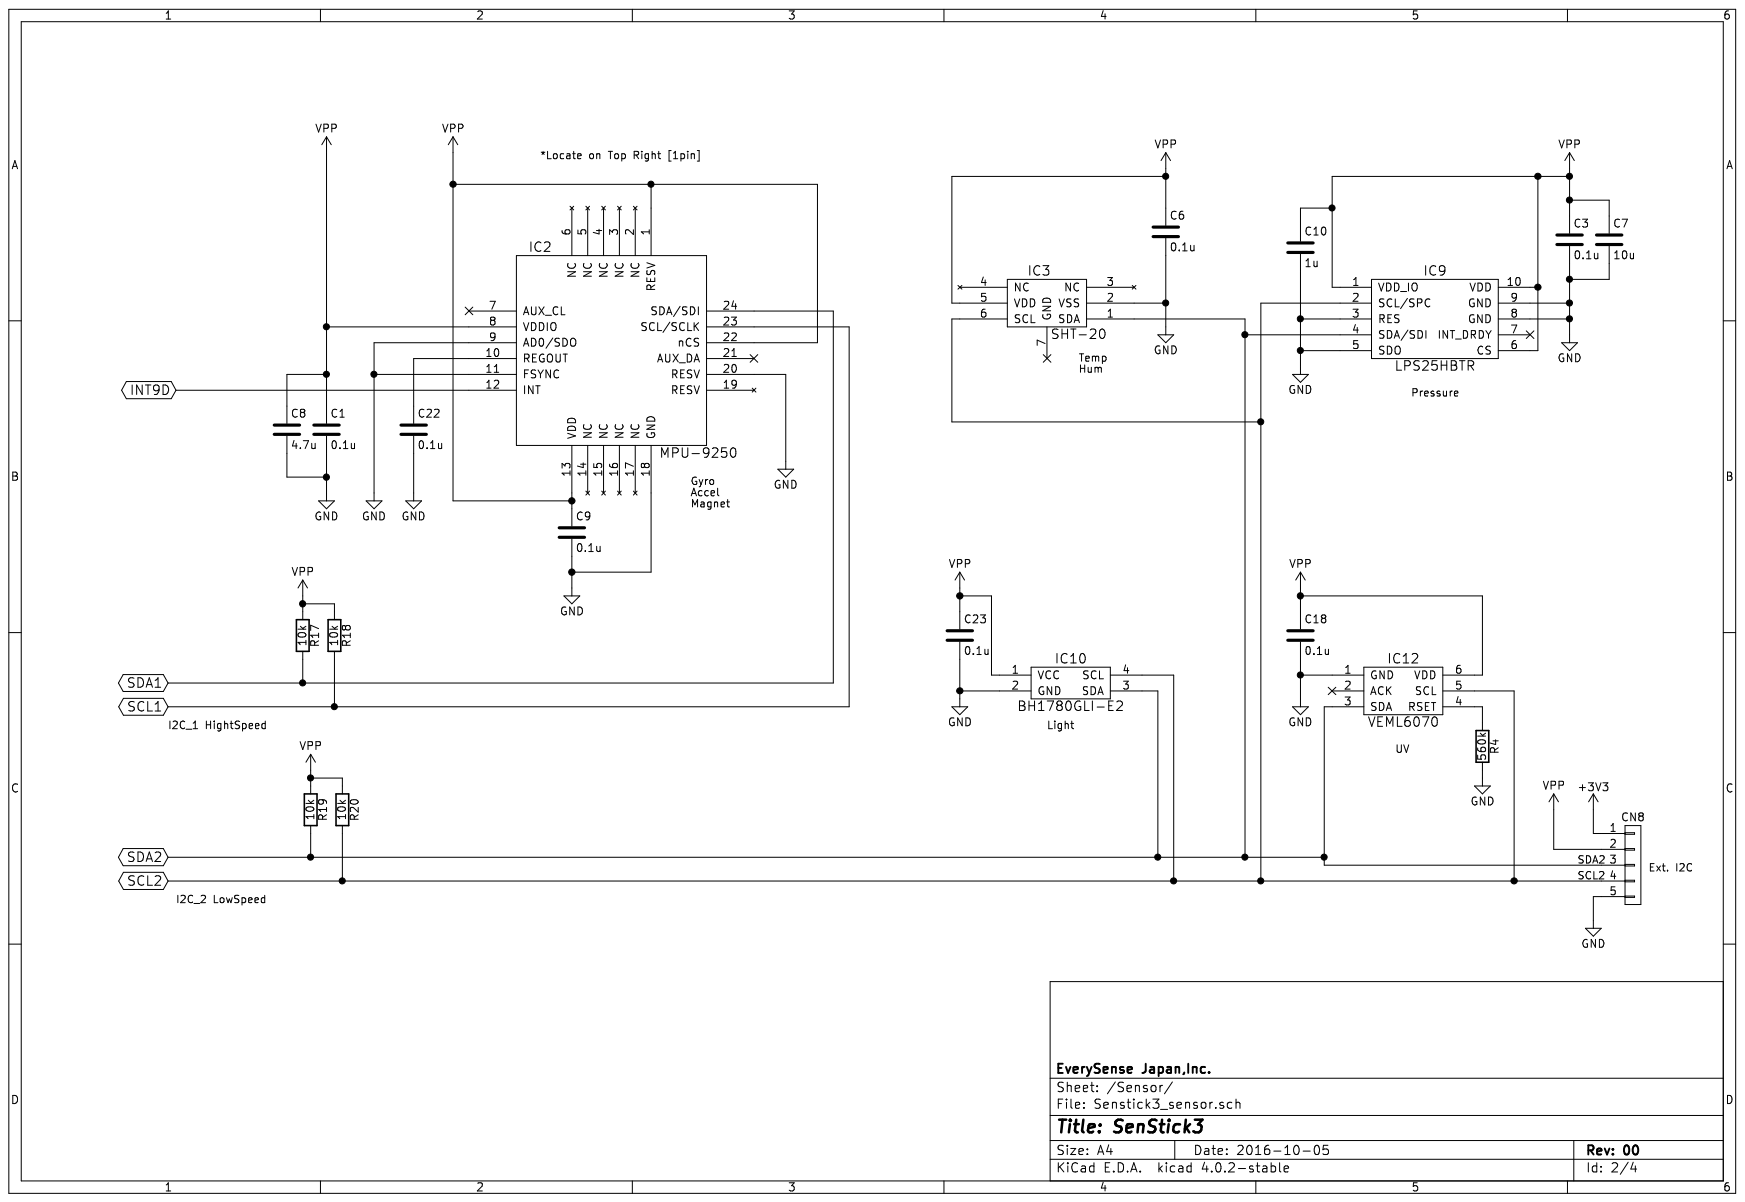
[picture p44: page 2]

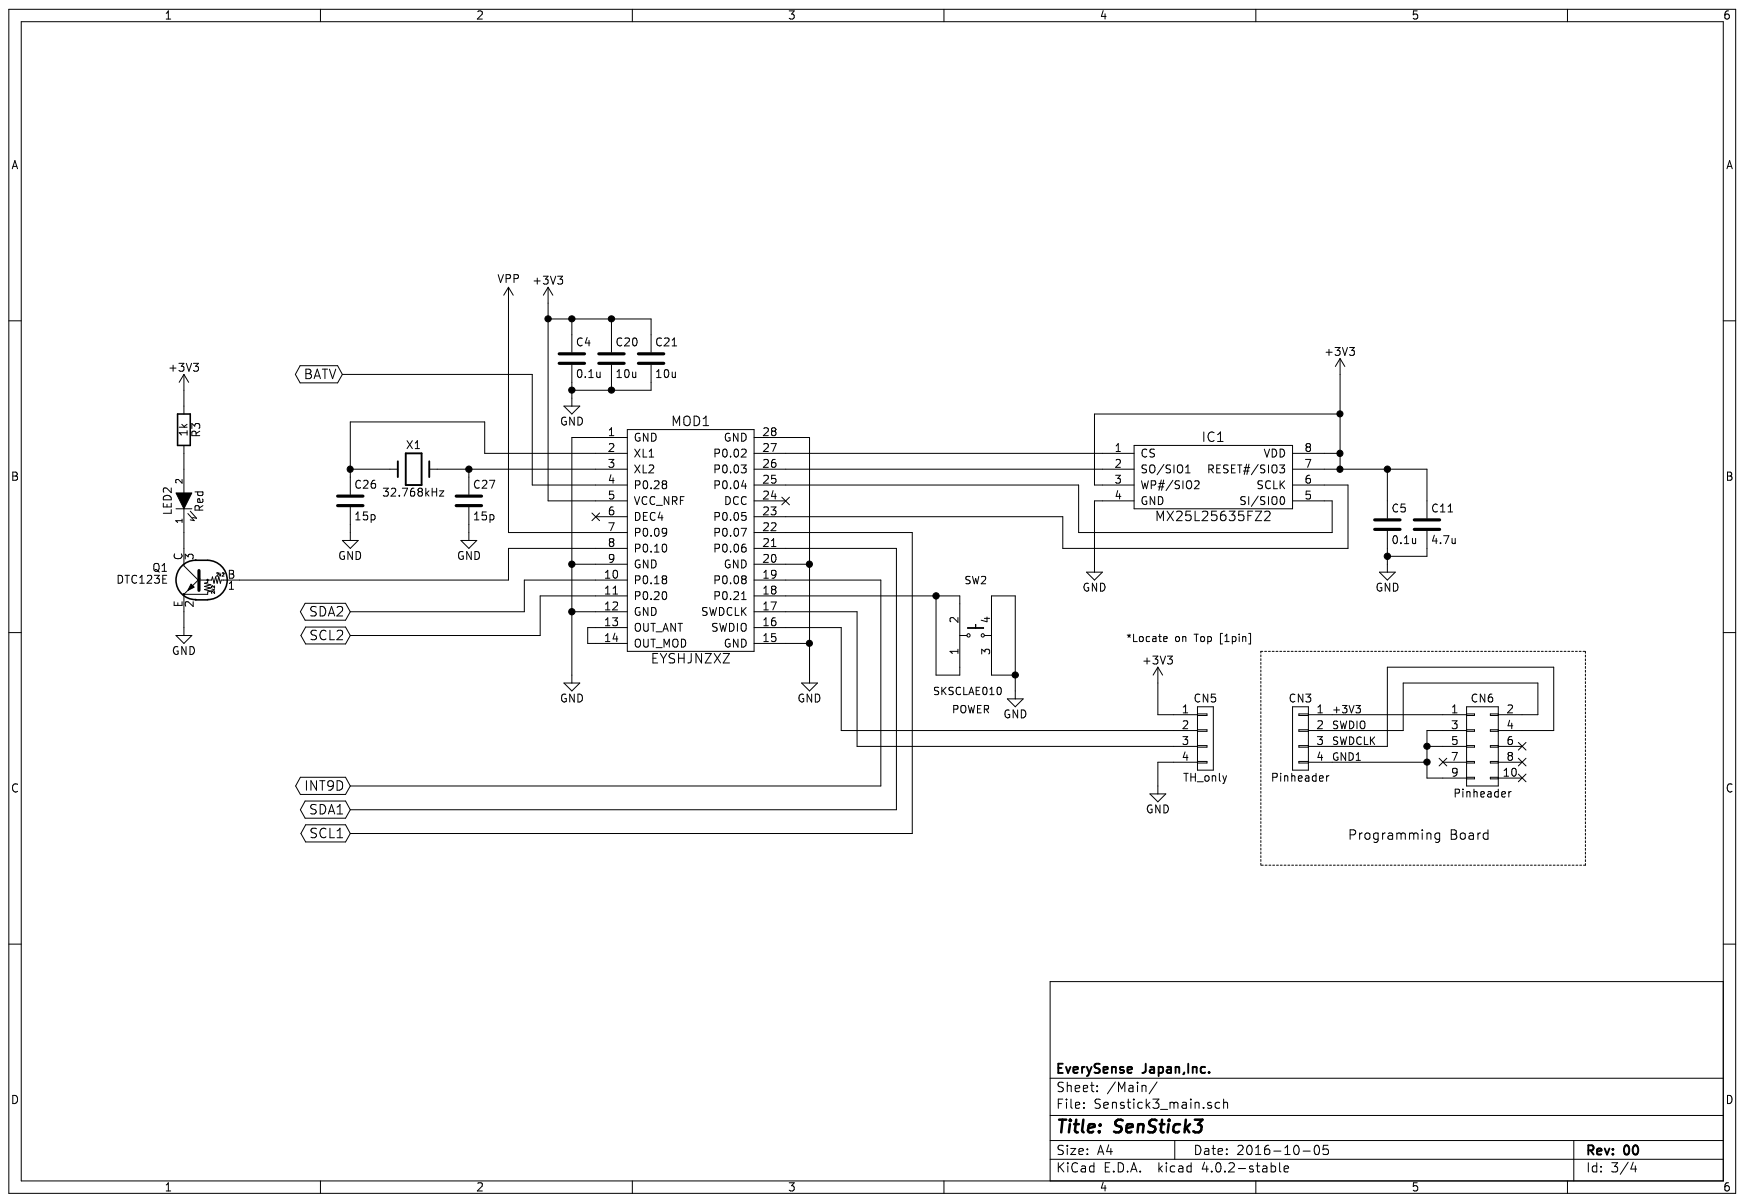
[picture p45: page 3]

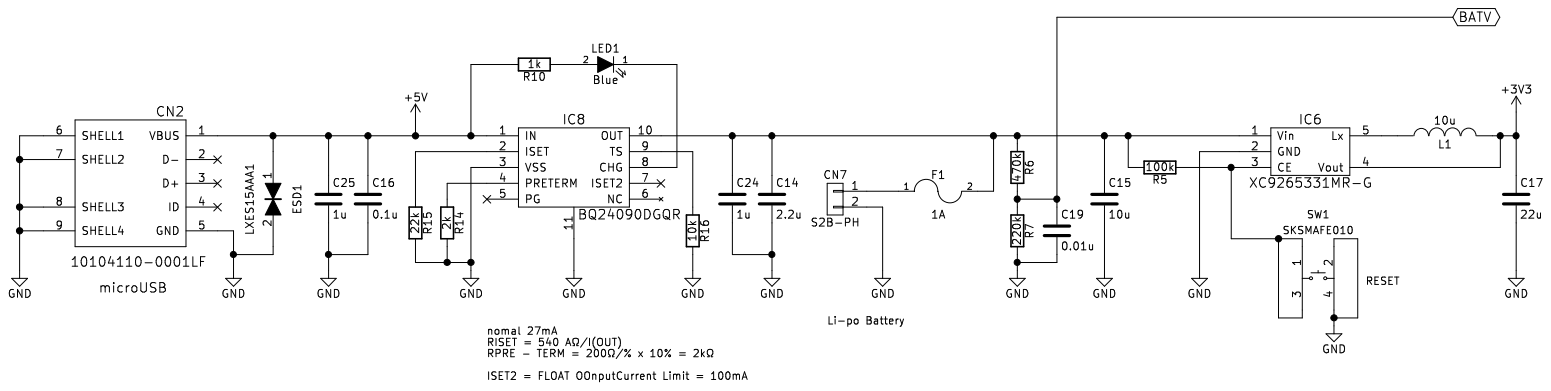
[picture p46: page 4]
