ubi-naist/SenStick/docs/nRF51_SenStick_ハードウェア資料/奈良先端回路図v33.pdf

## 最低作電圧は︖

## ⇒20uAは消費する

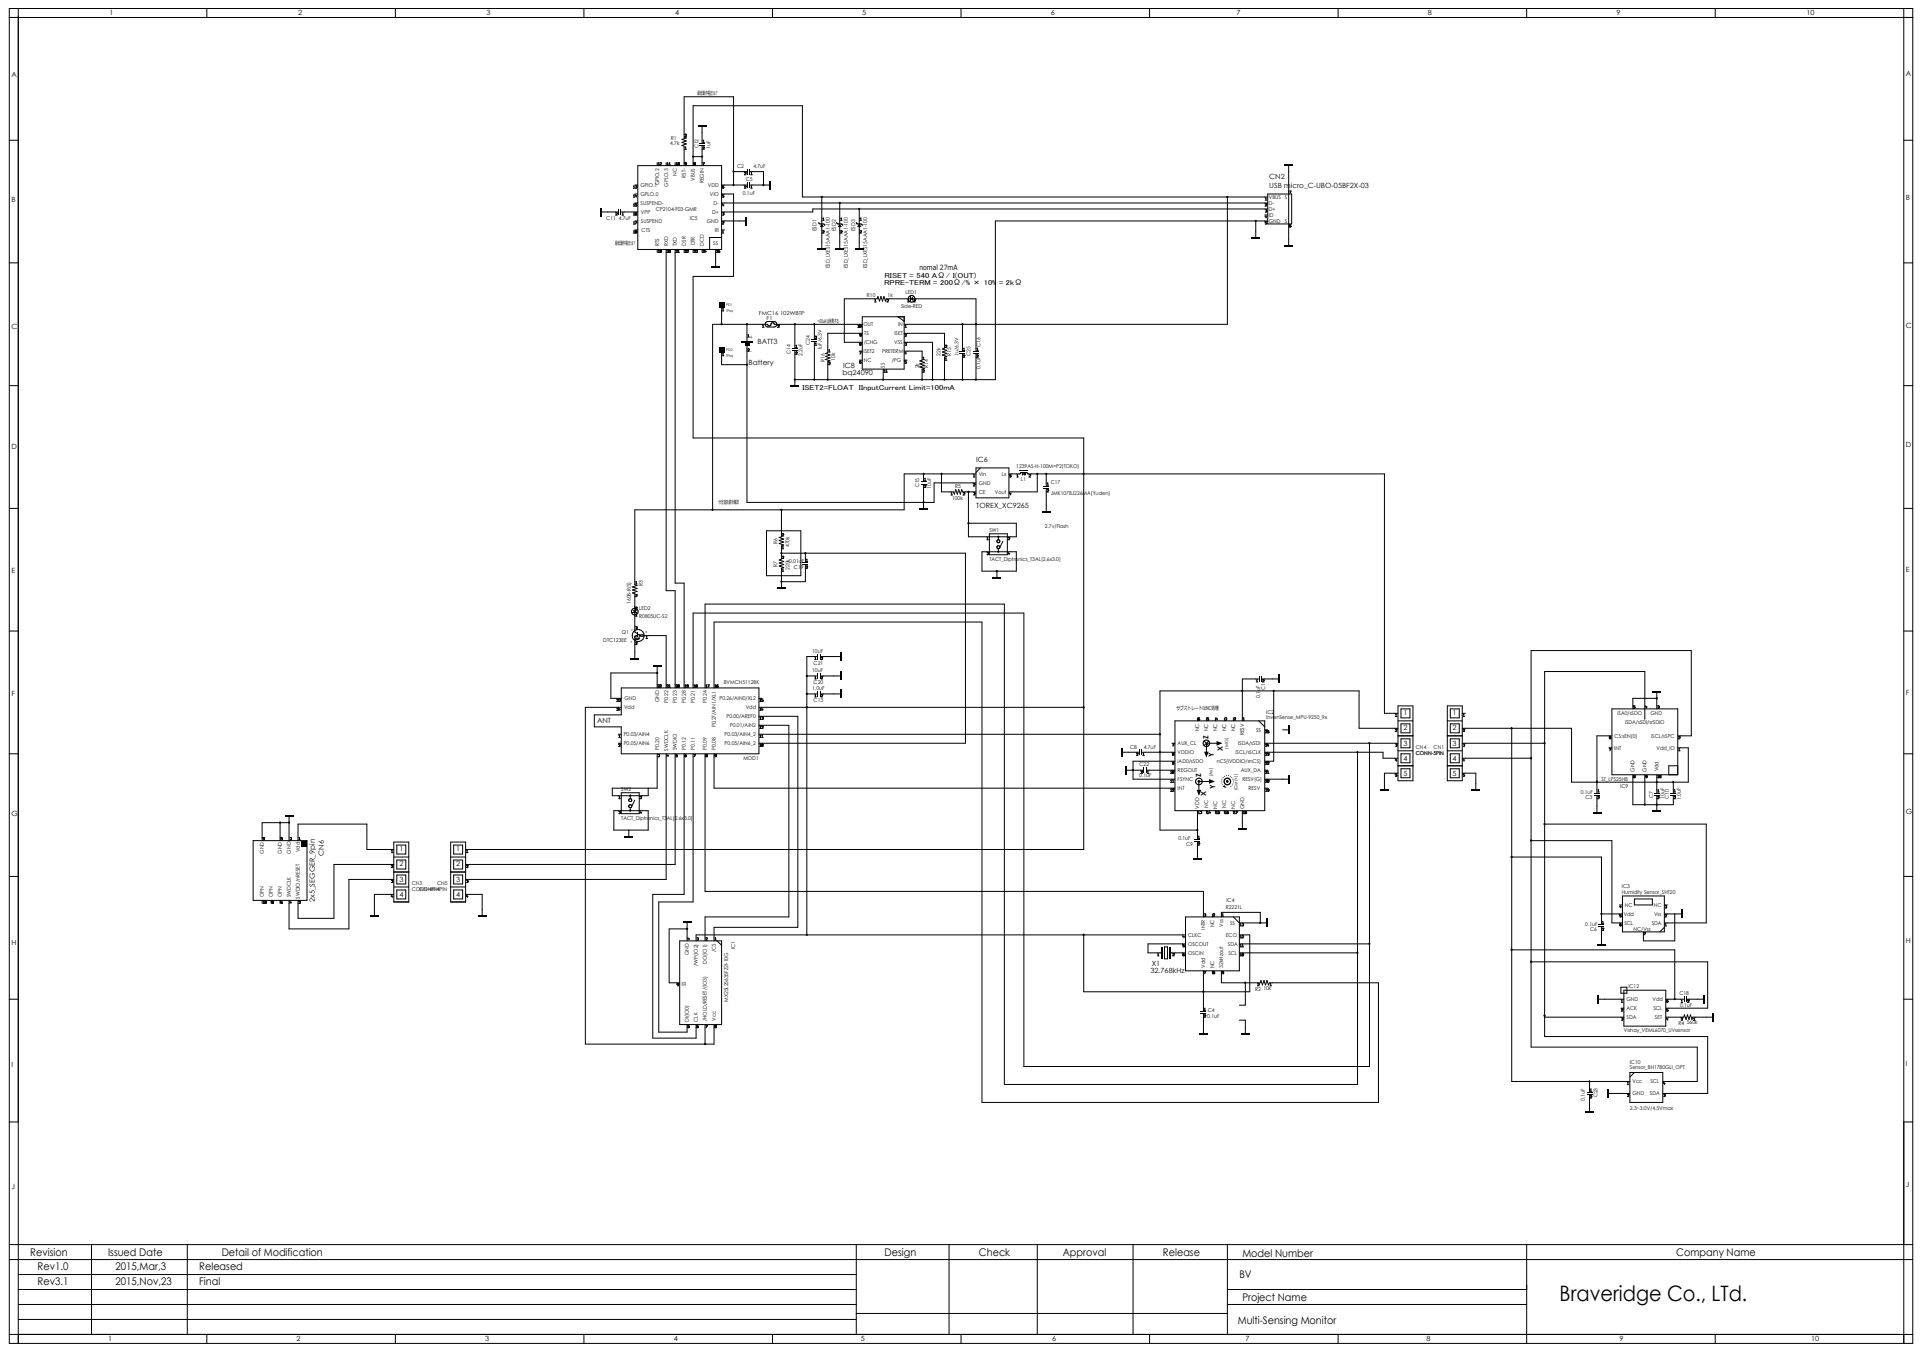
[picture p47: page 1]

Revision | Issued Date | Detail of Modification | Design | Check | Approval | Release | Model Number | Company Name
Rev1.0 | | Released 2015,Mar,3 | | | | | BV | Braveridge Co., LTd.
Rev3.1 | | Final 2015,Nov,23
