ubi-naist/SenStick/firmware/acceleration_sensor_base.h

#ifndef acceleration_sensor_base_h
#define acceleration_sensor_base_h

#include "senstick_sensor_base.h"

extern const senstick_sensor_base_t accelerationSensorBase;

#endif /* acceleration_sensor_base_h */
