ubi-naist/SenStick/firmware/twi_slave_uvsensor.h

#ifndef twi_slave_uvsensor_h
#define twi_slave_uvsensor_h

// UVセンサーの機能を提供します。

#include <stdint.h>
#include <stdbool.h>

#include "nrf_drv_twi.h"
#include "senstick_data_models.h"

// 構造体の宣言
typedef struct {
    nrf_drv_twi_t *p_twi;
} uv_sensor_context_t;

// 初期化関数。センサ使用前に必ずこの関数を呼出ます。
void initUVSensor(uv_sensor_context_t *p_context, nrf_drv_twi_t *p_twi);

//void getNineAxesData(nine_axes_sensor_context_t *p_context, MotionSensorData_t *sensor_data);

//void sleepNineAxesSensor(nine_axes_sensor_context_t *p_context);
//void awakeNineAxesSensor(nine_axes_sensor_context_t *p_context);


#endif /* twi_slave_uvsensor_h */
