ubi-naist/SenStick/firmware/nrf52_s132v3_sdk12/ble_stack.c

#include <string.h>

#include <ble.h>
#include <app_error.h>
#include <sdk_errors.h>
#include <softdevice_handler_appsh.h>

#include "ble_stack.h"

// Include or not the service_changed characteristic. if not enabled, the server's database cannot be changed for the lifetime of the device
#define IS_SRVC_CHANGED_CHARACT_PRESENT  1

// セントラル及びペリフェラルとしての、接続数の定義
#define CENTRAL_LINK_COUNT    0
#define PERIPHERAL_LINK_COUNT 1

// GATT MTUサイズの定義, GATT_MTU_SIZE_DEFAULT は ble_gatt.h で23に定義されている。
#define NRF_BLE_MAX_MTU_SIZE GATT_MTU_SIZE_DEFAULT

void init_ble_stack(sys_evt_handler_t systemHandler, ble_evt_handler_t bleHandler)
{
    ret_code_t err_code;
    
    // Initialize the SoftDevice handler module.
    // LFCLK crystal oscillator. 32kHz xtal外付け。
     nrf_clock_lf_cfg_t clock_lf_cfg = {
     .source        = NRF_CLOCK_LF_SRC_XTAL,
     .rc_ctiv       = 0,
     .rc_temp_ctiv  = 0,
     .xtal_accuracy = NRF_CLOCK_LF_XTAL_ACCURACY_20_PPM};
    // 太陽誘電 EYSHJNZXZ ver1.1 データシートの推奨設定。
    /*
    nrf_clock_lf_cfg_t clock_lf_cfg = {
        .source        = NRF_CLOCK_LF_SRC_RC,
        .rc_ctiv       = 16,
        .rc_temp_ctiv  = 2,
        .xtal_accuracy = NRF_CLOCK_LF_XTAL_ACCURACY_250_PPM};
*/
    // SOFTDEVICE_HANDLER_INIT(&clock_lf_cfg, NULL);
    SOFTDEVICE_HANDLER_APPSH_INIT(&clock_lf_cfg, true);      // BLEのスタックの処理は、スケジューラを使う。
    
    ble_enable_params_t ble_enable_params;
    err_code = softdevice_enable_get_default_config(CENTRAL_LINK_COUNT, PERIPHERAL_LINK_COUNT, &ble_enable_params);
    APP_ERROR_CHECK(err_code);
    
    // Check the ram settings against the used number of links
    CHECK_RAM_START_ADDR(CENTRAL_LINK_COUNT, PERIPHERAL_LINK_COUNT);
    
    // Enable BLE stack.
    // #if (NRF_SD_BLE_API_VERSION == 3)
    ble_enable_params.gatt_enable_params.att_mtu = NRF_BLE_MAX_MTU_SIZE;

    // nRF52, S132。アトリビュートのテーブルサイズ。S132 v3のデフォルトサイズは0x580。
    // 0x1000増やす。メモリ位置とサイズを start 0x20002128 / size 0xDED8 から start 0x20003128 / size 0xCED8 に変更する。
    ble_enable_params.gatts_enable_params.attr_tab_size   = 0x580 + 0x1000;
    ble_enable_params.gatts_enable_params.service_changed = IS_SRVC_CHANGED_CHARACT_PRESENT;
    
    err_code = softdevice_enable(&ble_enable_params);
    APP_ERROR_CHECK(err_code);
    
    // Register with the SoftDevice handler module for BLE events.
    err_code = softdevice_ble_evt_handler_set(bleHandler);
    APP_ERROR_CHECK(err_code);
    
    // Register with the SoftDevice handler module for BLE events.
    err_code = softdevice_sys_evt_handler_set(systemHandler);
    APP_ERROR_CHECK(err_code);
}
