ubi-naist/SenStick/nRF5_SDK_12/examples/ant/ant_relay_demo/main.c

/*
This software is subject to the license described in the license.txt file
included with this software distribution. You may not use this file except in compliance
with this license.

Copyright (c) Dynastream Innovations Inc. 2013
All rights reserved.
*/

/**@file
 * @defgroup nrf_ant_relay_demo ANT Relay Example
 * @{
 * @ingroup nrf_ant_relay_demo
 *
 * @brief Example of ANT Relay implementation.
 *
 * Before compiling this example for NRF52, complete the following steps:
 * - Download the S212 SoftDevice from <a href="https://www.thisisant.com/developer/components/nrf52832" target="_blank">thisisant.com</a>.
 * - Extract the downloaded zip file and copy the S212 SoftDevice headers to <tt>\<InstallFolder\>/components/softdevice/s212/headers</tt>.
 * If you are using Keil packs, copy the files into a @c headers folder in your example folder.
 * - Make sure that @ref ANT_LICENSE_KEY in @c nrf_sdm.h is uncommented.
 */

#include <string.h>
#include "app_error.h"
#include "app_util.h"
#include "ant_interface.h"
#include "ant_parameters.h"
#include "nrf_soc.h"
#include "nrf.h"
#include "bsp.h"
#include "hardfault.h"
#include "app_timer.h"
#include "ant_stack_config.h"
#include "ant_channel_config.h"
#include "softdevice_handler.h"

// Global channel parameters
#define ANT_CHANNEL_DEFAULT_NETWORK     0x00                        /**< ANT Channel Network. */
#define EXT_ASSIGN_NONE                 0x00                        /**< ANT Ext Assign. */
#define ANT_RELAY_MAIN_PAGE             ((uint8_t) 1)               /**< Main status page for relay interface channel. */

#define ANT_MOBILE_CHANNEL              ((uint8_t) 0)               /**< Mobile phone interface channel - ANT Channel 0. */
#define ANT_RELAY_MASTER_CHANNEL        ((uint8_t) 1)               /**< Device to device master channel - ANT Channel 1. */
#define ANT_RELAY_SLAVE_CHANNEL         ((uint8_t) 2)               /**< Device to device slave channel - ANT Channel 2. */

#define APP_TIMER_PRESCALER             0                           /**< Value of the RTC1 PRESCALER register. */
#define APP_TIMER_OP_QUEUE_SIZE         2u                          /**< Size of timer operation queues. */


typedef enum{
    ANT_LED_STATE_OFF = 0,
    ANT_LED_STATE_ON  = 1
} ant_led_state_t;

typedef enum
{
    ANT_PAGE_NUMBER_FIELD_OFFSET    = 0,
    ANT_LED_STATUS_FIELD_OFFSET     = 1,
    ANT_COUNTER_FIELD_OFFSET        = 2,
    ANT_STATE_FIELD_OFFSET          = 7
} ant_message_field_offset_t;

typedef enum
{
    ANT_MOBILE_MAIN_PAGE    = 1,                                      /**< Main status page for mobile interface channel. */
    ANT_MOBILE_COMMAND_PAGE = 2                                       /**< Command page for mobile interface (from mobile to device). */
} ant_mobile_command_t;

typedef enum
{
    ANT_COMMAND_PAIRING = 1,
    ANT_COMMAND_ON      = 2,
    ANT_COMMAND_OFF     = 3
} ant_state_command_t;

// Static variables and buffers.
static uint32_t  m_led_change_counter = 0;

/**@brief Decode and handle the main relay page.
 *  set the LED if required.
 *
 * @param[in] p_payload ANT message 8-byte payload.
 */
void ant_relay_main_page_handle(uint8_t* p_payload)
{
    uint32_t counter =  uint32_decode(p_payload + ANT_COUNTER_FIELD_OFFSET);

    // If counter changed, set the led to what
    // we received in the message.
    if (counter > m_led_change_counter)
    {
        uint8_t led_state = p_payload[ANT_LED_STATUS_FIELD_OFFSET];
        if (led_state == ANT_LED_STATE_ON)
        {
            bsp_board_led_on(BSP_BOARD_LED_0);
        }
        else
        {
            bsp_board_led_off(BSP_BOARD_LED_0);
        }

        m_led_change_counter = counter;
    }
}

/**@brief Function for creating and sending main
 * relay data page.
 *
 * @param[in] channel ANT channel on which to send this message.
 */
void ant_relay_main_message_assemble(uint8_t channel)
{
    uint8_t status;
    uint32_t err_code = sd_ant_channel_status_get(ANT_RELAY_SLAVE_CHANNEL, &status);
    APP_ERROR_CHECK(err_code);

    uint8_t broadcast_data[ANT_STANDARD_DATA_PAYLOAD_SIZE];
    memset(broadcast_data, 0xFF, sizeof(broadcast_data));
    broadcast_data[ANT_PAGE_NUMBER_FIELD_OFFSET]  = ANT_RELAY_MAIN_PAGE;
    broadcast_data[ANT_LED_STATUS_FIELD_OFFSET]   = ( bsp_board_led_state_get(BSP_BOARD_LED_0) )?
                                                      ANT_LED_STATE_ON : ANT_LED_STATE_OFF;
    broadcast_data[ANT_STATE_FIELD_OFFSET]        = status & STATUS_CHANNEL_STATE_MASK;
    UNUSED_RETURN_VALUE(uint32_encode(m_led_change_counter, broadcast_data + ANT_COUNTER_FIELD_OFFSET));

    err_code = sd_ant_broadcast_message_tx(channel, ANT_STANDARD_DATA_PAYLOAD_SIZE, broadcast_data);
    APP_ERROR_CHECK(err_code);
}

/**@brief Process ANT message on ANT relay master channel
 *
 * @param[in] p_ant_event ANT message content.
 */
void ant_relay_master_process(ant_evt_t* p_ant_event)
{
    ANT_MESSAGE* p_ant_message = (ANT_MESSAGE*)p_ant_event->msg.evt_buffer;
    switch (p_ant_event->event)
    {
        case EVENT_RX:
            switch (p_ant_message->ANT_MESSAGE_aucPayload[0])
            {
                case ANT_RELAY_MAIN_PAGE:
                    ant_relay_main_page_handle(p_ant_message->ANT_MESSAGE_aucPayload);
                    break;

            }
            break;

        case EVENT_TX:
            ant_relay_main_message_assemble(ANT_RELAY_MASTER_CHANNEL);
            break;

        default:
            break;

    }
}

/**@brief Process ANT message on ANT slave relay channel
 *
 * @param[in] p_ant_event ANT message content.
 */
void ant_relay_slave_process(ant_evt_t* p_ant_event)
{
    static bool first_recieved = false;
    ANT_MESSAGE* p_ant_message = (ANT_MESSAGE*)p_ant_event->msg.evt_buffer;

    switch (p_ant_event->event)
    {
        case EVENT_RX:
        {
            switch (p_ant_message->ANT_MESSAGE_aucPayload[0])
            {
                case ANT_RELAY_MAIN_PAGE:
                    ant_relay_main_page_handle(p_ant_message->ANT_MESSAGE_aucPayload);
                    break;

            }

            bsp_board_led_on(BSP_BOARD_LED_1);

            if (first_recieved)
            {
                break;
            }
            else
            {
                first_recieved = true;
            }
        }
        // fall-through

        case EVENT_TX:
        {
            ant_relay_main_message_assemble(ANT_RELAY_SLAVE_CHANNEL);
            break;
        }
        case EVENT_RX_SEARCH_TIMEOUT:
        {
            // Channel has closed.
            // Re-initialize proximity search settings.
            uint32_t err_code = sd_ant_prox_search_set(ANT_RELAY_SLAVE_CHANNEL, RELAY_PROXIMITY_BIN, 0);
            APP_ERROR_CHECK(err_code);
            bsp_board_led_off(BSP_BOARD_LED_1);
            break;
        }
        default:
        {
            break;
        }

    }
}

/**@brief Process ANT message on ANT mobile interface channel
 *
 * @details   This function handles all events on the mobile interface channel.
 *            On EVENT_TX an ANT_MOBILE_MAIN_PAGE message is queue. The format is:
 *            byte[0]   = page (1 = ANT_MOBILE_MAIN_PAGE)
 *            byte[1]   = led state (1 = 0N, 0 = OFF)
 *            byte[2-6] = reserved (0xFF)
 *            byte[7]   = relay slave channel status (0 = unnassigned, 1 = assigned, 2 = searching, 3 = tracking)
 *
 *            On EVENT_RX the function will decode an ANT_MOBILE_COMMAND_PAGE. The format is:
 *            byte[0]   = page (2 = ANT_MOBILE_COMMAND_PAGE)
 *            byte[1]   = reserved (Set to 0xFF)
 *            byte[2]   = command (1 = pairing, 2 = led on, 3 = led off)
 *            byte[3-7] = reserved (Set to 0xFF)
 *
 * @param[in] p_ant_event ANT message content.
 */
void ant_mobile_process(ant_evt_t* p_ant_event)
{
    ANT_MESSAGE* p_ant_message = (ANT_MESSAGE*)p_ant_event->msg.evt_buffer;
    switch (p_ant_event->event)
    {
        case EVENT_RX:
            switch (p_ant_message->ANT_MESSAGE_aucPayload[0])
            {
                case ANT_MOBILE_COMMAND_PAGE:
                    switch (p_ant_message->ANT_MESSAGE_aucPayload[2])
                    {
                        case ANT_COMMAND_ON:
                            bsp_board_led_on(BSP_BOARD_LED_0);
                            m_led_change_counter++;
                            break;

                        case ANT_COMMAND_OFF:
                            bsp_board_led_off(BSP_BOARD_LED_0);
                            m_led_change_counter++;
                            break;

                        case ANT_COMMAND_PAIRING:
                        {
                            uint8_t channel_status;
                            uint32_t err_code = sd_ant_channel_status_get (ANT_RELAY_SLAVE_CHANNEL,
                                                                           &channel_status);
                            APP_ERROR_CHECK(err_code);

                            if ((channel_status & STATUS_CHANNEL_STATE_MASK) == STATUS_ASSIGNED_CHANNEL)
                            {
                                err_code = sd_ant_channel_open(ANT_RELAY_SLAVE_CHANNEL);
                                APP_ERROR_CHECK(err_code);
                            }
                            break;
                        }
                    }
                    break;

                default:
                    break;
            }
            break;

        case EVENT_TX:
        {
            uint8_t status;

            uint32_t err_code = sd_ant_channel_status_get(ANT_RELAY_SLAVE_CHANNEL, &status);
            APP_ERROR_CHECK(err_code);

            uint8_t broadcast_data[ANT_STANDARD_DATA_PAYLOAD_SIZE];
            memset(broadcast_data, 0xFF, sizeof(broadcast_data));
            broadcast_data[0] = ANT_MOBILE_MAIN_PAGE;
            broadcast_data[1] = ( bsp_board_led_state_get(BSP_BOARD_LED_0) )? ANT_LED_STATE_ON : ANT_LED_STATE_OFF;
            broadcast_data[7] = status & STATUS_CHANNEL_STATE_MASK;
            err_code          = sd_ant_broadcast_message_tx(ANT_MOBILE_CHANNEL,
                                                            ANT_STANDARD_DATA_PAYLOAD_SIZE,
                                                            broadcast_data);
            APP_ERROR_CHECK(err_code);

            break;
        }
        default:
            break;

    }
}

/**@brief Function for dispatching a ANT stack event to all modules with a ANT stack event handler.
 *
 * @details This function is called from the ANT Stack event interrupt handler after a ANT stack
 *          event has been received.
 *
 * @param[in] p_ant_evt  ANT stack event.
 */
void ant_evt_dispatch(ant_evt_t * p_ant_evt)
{
    switch (p_ant_evt->channel)
    {
        case ANT_RELAY_MASTER_CHANNEL:
            ant_relay_master_process(p_ant_evt);
            break;

        case ANT_RELAY_SLAVE_CHANNEL:
            ant_relay_slave_process(p_ant_evt);
            break;

        case ANT_MOBILE_CHANNEL:
            ant_mobile_process(p_ant_evt);
            break;

        default:
            break;
    }
}

/**@brief Function for handling bsp events.
 */
void bsp_evt_handler(bsp_event_t evt)
{
    switch (evt)
    {
        case BSP_EVENT_KEY_0:
            // Toggle the state of the LED
            m_led_change_counter++;

            bsp_board_led_invert(BSP_BOARD_LED_0);
            break;

        case BSP_EVENT_KEY_1:
        {
            // Open slave channel
            uint8_t channel_status;
            uint32_t err_code = sd_ant_channel_status_get(ANT_RELAY_SLAVE_CHANNEL, &channel_status);
            APP_ERROR_CHECK(err_code);

            if ((channel_status & STATUS_CHANNEL_STATE_MASK) == STATUS_ASSIGNED_CHANNEL)
            {
                err_code = sd_ant_channel_open(ANT_RELAY_SLAVE_CHANNEL);
                APP_ERROR_CHECK(err_code);
            }
            break;
        }

        default:
            return; // no implementation needed
    }
}

/**
 * @brief Function for setting up all things not directly associated witch ANT stack/protocol.
 */
static void utils_setup(void)
{
    // Initialize and start a single continuous mode timer, which is used to update the event time
    // on the main data page.
    APP_TIMER_INIT(APP_TIMER_PRESCALER, APP_TIMER_OP_QUEUE_SIZE, NULL);

    uint32_t err_code = bsp_init(BSP_INIT_LED | BSP_INIT_BUTTONS,
                                 APP_TIMER_TICKS(100, APP_TIMER_PRESCALER),
                                 bsp_evt_handler);
    APP_ERROR_CHECK(err_code);
}


/**@brief Function for ANT stack initialization.
 *
 * @details Initializes the SoftDevice and the ANT event interrupt.
 */
static void softdevice_setup(void)
{
    uint32_t err_code;
    nrf_clock_lf_cfg_t clock_lf_cfg = NRF_CLOCK_LFCLKSRC;

    err_code = softdevice_ant_evt_handler_set(ant_evt_dispatch);
    APP_ERROR_CHECK(err_code);

    err_code = softdevice_handler_init(&clock_lf_cfg, NULL, 0, NULL);
    APP_ERROR_CHECK(err_code);

    err_code = ant_stack_static_config();
    APP_ERROR_CHECK(err_code);
}


/**@brief Function for setting up the ANT channels
 *
 */
static void ant_channel_setup(void)
{
    uint32_t err_code;

    // !! CONFIGURE MOBILE CHANNEL !! //

    /* The purpose of the mobile channel is to provide an independent link
       to a mobile platform using ANT. The mobile channel will report the
       status of the LED as well as the status of the slave relay channel
       (closed/open/searching). The mobile channel will also accept commands
       which emulate the function of the development board. For example, to
       set the the set the state of the led or to put the device into pairing
       mode.
    */

    ant_channel_config_t mobile_channel_config =
    {
        .channel_number     = ANT_MOBILE_CHANNEL,
        .channel_type       = CHANNEL_TYPE_MASTER,
        .ext_assign         = EXT_ASSIGN_NONE,
        .rf_freq            = MOBILE_RF_FREQ,
        .transmission_type  = MOBILE_CHAN_ID_TRANS_TYPE,
        .device_type        = MOBILE_CHAN_ID_DEV_TYPE,
        .device_number      = (uint16_t) (NRF_FICR->DEVICEID[0]),
        .channel_period     = MOBILE_CHAN_PERIOD,
        .network_number     = ANT_CHANNEL_DEFAULT_NETWORK,
    };

    err_code = ant_channel_init(&mobile_channel_config);
    APP_ERROR_CHECK(err_code);

    // Open channel right away.
    err_code = sd_ant_channel_open(ANT_MOBILE_CHANNEL);
    APP_ERROR_CHECK(err_code);

    // !! CONFIGURE RELAY MASTER CHANNEL !! //

    /* The relay master channel is always on and transmits the
       status of the LED and the status of the slave relay channel
       (open/closed/searching). It is 100% bi-directional once
       a slave connects to it (status updates from the slave are
       sent on every message period)
    */

    ant_channel_config_t relay_master_channel_config =
    {
        .channel_number     = ANT_RELAY_MASTER_CHANNEL,
        .channel_type       = CHANNEL_TYPE_MASTER,
        .ext_assign         = EXT_ASSIGN_NONE,
        .rf_freq            = RELAY_RF_FREQ,
        .transmission_type  = RELAY_CHAN_ID_TRANS_TYPE,
        .device_type        = RELAY_CHAN_ID_DEV_TYPE,
        .device_number      = (uint16_t) (NRF_FICR->DEVICEID[0]),
        .channel_period     = RELAY_CHAN_PERIOD,
        .network_number     = ANT_CHANNEL_DEFAULT_NETWORK,
    };

    err_code = ant_channel_init(&relay_master_channel_config);
    APP_ERROR_CHECK(err_code);

    // Open channel right away.
    err_code = sd_ant_channel_open(ANT_RELAY_MASTER_CHANNEL);
    APP_ERROR_CHECK(err_code);

    // !! CONFIGURE RELAY SLAVE CHANNEL !! //

    /* The purpose of the relay slave channel is to find and synchronize
       to another devices master really channel. The slave channel is only
       opened on a button press and uses proximity pairing to connect to a
       master channel. Once tracking a master the slave channel will send status
       message back to the master 100% of the time.
    */

    ant_channel_config_t relay_slave_channel_config =
    {
        .channel_number     = ANT_RELAY_SLAVE_CHANNEL,
        .channel_type       = CHANNEL_TYPE_SLAVE,
        .ext_assign         = EXT_ASSIGN_NONE,
        .rf_freq            = RELAY_RF_FREQ,
        .transmission_type  = RELAY_CHAN_ID_TRANS_TYPE,
        .device_type        = RELAY_CHAN_ID_DEV_TYPE,
        .device_number      = 0x00,                     // Wildcard
        .channel_period     = RELAY_CHAN_PERIOD,
        .network_number     = ANT_CHANNEL_DEFAULT_NETWORK,
    };

    err_code = ant_channel_init(&relay_slave_channel_config);
    APP_ERROR_CHECK(err_code);

    err_code = sd_ant_prox_search_set(ANT_RELAY_SLAVE_CHANNEL, RELAY_PROXIMITY_BIN, 0);
    APP_ERROR_CHECK(err_code);

    // DO NOT OPEN THE SLAVE RIGHT AWAY - IT OPENS ON BUTTON PRESS
    // OR MESSAGE FROM MOBILE PHONE
}


/**@brief Function for application main entry. Does not return.
 */
int main(void)
{
    // Configure LEDs and buttons.
    utils_setup();

    // Enable SoftDevice.
    softdevice_setup();

    // Setup Channel_0 as a TX Master Only.
    ant_channel_setup();

    // Main loop.
    for (;;)
    {
        // Put CPU in sleep if possible.
        uint32_t err_code = sd_app_evt_wait();
        APP_ERROR_CHECK(err_code);
    }
}

/**
 *@}
 **/
