ubi-naist/SenStick/nRF5_SDK_12/examples/ble_central_and_peripheral/experimental/ble_app_hrs_rscs_relay/main.c

/*
 * Copyright (c) 2014 Nordic Semiconductor. All Rights Reserved.
 *
 * The information contained herein is confidential property of Nordic Semiconductor. The use,
 * copying, transfer or disclosure of such information is prohibited except by express written
 * agreement with Nordic Semiconductor.
 *
 */

/**
 * @brief BLE Heart Rate and Running speed Relay application main file.
 *
 * @detail This application demonstrates a simple "Relay".
 * Meaning we pass on the values that we receive. By combining a collector part on
 * one end and a sensor part on the other, we show that the s130 can function
 * simultaneously as a central and a peripheral device.
 *
 * In the figure below, the sensor ble_app_hrs connects and interacts with the relay
 * in the same manner it would connect to a heart rate collector. In this case, the Relay
 * application acts as a central.
 *
 * On the other side, a collector (such as Master Control panel or ble_app_hrs_c) connects
 * and interacts with the relay the same manner it would connect to a heart rate sensor peripheral.
 *
 * Led layout:
 * LED 1: Central side is scanning       LED 2: Central side is connected to a peripheral
 * LED 3: Peripheral side is advertising LED 4: Peripheral side is connected to a central
 *
 * @note While testing, be careful that the Sensor and Collector are actually connecting to the Relay,
 *       and not directly to each other!
 *
 *    Peripheral                  Relay                    Central
 *    +--------+        +-----------|----------+        +-----------+
 *    | Heart  |        | Heart     |   Heart  |        |           |
 *    | Rate   | -----> | Rate     -|-> Rate   | -----> | Collector |
 *    | Sensor |        | Collector |   Sensor |        |           |
 *    +--------+        +-----------|   and    |        +-----------+
 *                      | Running   |   Running|
 *    +--------+        | Speed    -|-> Speed  |
 *    | Running|------> | Collector |   Sensor |
 *    | Speed  |        +-----------|----------+
 *    | Sensor |
 *    +--------+
 */

#include <stdint.h>
#include <stdio.h>
#include <string.h>
#include "nordic_common.h"
#include "softdevice_handler.h"
#include "peer_manager.h"
#include "app_timer.h"
#include "boards.h"
#include "bsp.h"
#include "bsp_btn_ble.h"
#include "ble.h"
#include "ble_advdata.h"
#include "ble_advertising.h"
#include "ble_conn_params.h"
#include "ble_db_discovery.h"
#include "ble_hrs.h"
#include "ble_rscs.h"
#include "ble_hrs_c.h"
#include "ble_rscs_c.h"
#include "ble_conn_state.h"
#include "fstorage.h"
#include "fds.h"

#define NRF_LOG_MODULE_NAME "APP"
#include "nrf_log.h"
#include "nrf_log_ctrl.h"

#if (NRF_SD_BLE_API_VERSION == 3)
#define NRF_BLE_MAX_MTU_SIZE        GATT_MTU_SIZE_DEFAULT                         /**< MTU size used in the softdevice enabling and to reply to a BLE_GATTS_EVT_EXCHANGE_MTU_REQUEST event. */
#endif

#define APP_FEATURE_NOT_SUPPORTED   BLE_GATT_STATUS_ATTERR_APP_BEGIN + 2          /**< Reply when unsupported features are requested. */

#define CENTRAL_LINK_COUNT          2                                             /**< Number of central links used by the application. When changing this number remember to adjust the RAM settings*/
#define PERIPHERAL_LINK_COUNT       1                                             /**< Number of peripheral links used by the application. When changing this number remember to adjust the RAM settings*/

#define UART_TX_BUF_SIZE            256                                           /**< Size of the UART TX buffer, in bytes. Must be a power of two. */
#define UART_RX_BUF_SIZE            1                                             /**< Size of the UART RX buffer, in bytes. Must be a power of two. */

/* Central related. */

#define CENTRAL_SCANNING_LED        BSP_BOARD_LED_0
#define CENTRAL_CONNECTED_LED       BSP_BOARD_LED_1

#define APP_TIMER_PRESCALER         0                                             /**< Value of the RTC1 PRESCALER register. */
#define APP_TIMER_MAX_TIMERS        (2 + BSP_APP_TIMERS_NUMBER)                   /**< Maximum number of timers used by the application. */
#define APP_TIMER_OP_QUEUE_SIZE     2                                             /**< Size of timer operation queues. */

#define SEC_PARAM_BOND              1                                             /**< Perform bonding. */
#define SEC_PARAM_MITM              0                                             /**< Man In The Middle protection not required. */
#define SEC_PARAM_LESC              0                                             /**< LE Secure Connections not enabled. */
#define SEC_PARAM_KEYPRESS          0                                             /**< Keypress notifications not enabled. */
#define SEC_PARAM_IO_CAPABILITIES   BLE_GAP_IO_CAPS_NONE                          /**< No I/O capabilities. */
#define SEC_PARAM_OOB               0                                             /**< Out Of Band data not available. */
#define SEC_PARAM_MIN_KEY_SIZE      7                                             /**< Minimum encryption key size in octets. */
#define SEC_PARAM_MAX_KEY_SIZE      16                                            /**< Maximum encryption key size in octets. */

#define SCAN_INTERVAL               0x00A0                                        /**< Determines scan interval in units of 0.625 millisecond. */
#define SCAN_WINDOW                 0x0050                                        /**< Determines scan window in units of 0.625 millisecond. */
#define SCAN_TIMEOUT                0

#define MIN_CONNECTION_INTERVAL     (uint16_t) MSEC_TO_UNITS(7.5, UNIT_1_25_MS)   /**< Determines minimum connection interval in milliseconds. */
#define MAX_CONNECTION_INTERVAL     (uint16_t) MSEC_TO_UNITS(30, UNIT_1_25_MS)    /**< Determines maximum connection interval in milliseconds. */
#define SLAVE_LATENCY               0                                             /**< Determines slave latency in terms of connection events. */
#define SUPERVISION_TIMEOUT         (uint16_t) MSEC_TO_UNITS(4000, UNIT_10_MS)    /**< Determines supervision time-out in units of 10 milliseconds. */

#define UUID16_SIZE                 2                                             /**< Size of a UUID, in bytes. */

/**@brief Macro to unpack 16bit unsigned UUID from an octet stream. */
#define UUID16_EXTRACT(DST, SRC) \
    do                           \
    {                            \
        (*(DST))   = (SRC)[1];   \
        (*(DST)) <<= 8;          \
        (*(DST))  |= (SRC)[0];   \
    } while (0)

/**@brief Variable length data encapsulation in terms of length and pointer to data. */
typedef struct
{
    uint8_t     * p_data;    /**< Pointer to data. */
    uint16_t      data_len;  /**< Length of data. */
} data_t;

/**
 * @brief Parameters used when scanning.
 */
static const ble_gap_scan_params_t m_scan_params =
{
    .active   = 1,
    .interval = SCAN_INTERVAL,
    .window   = SCAN_WINDOW,
    .timeout  = SCAN_TIMEOUT,
    #if (NRF_SD_BLE_API_VERSION == 2)
        .selective   = 0,
        .p_whitelist = NULL,
    #endif
    #if (NRF_SD_BLE_API_VERSION == 3)
        .use_whitelist = 0,
    #endif
};

/**@brief Connection parameters requested for connection. */
static const ble_gap_conn_params_t m_connection_param =
{
    (uint16_t)MIN_CONNECTION_INTERVAL,
    (uint16_t)MAX_CONNECTION_INTERVAL,
    0,
    (uint16_t)SUPERVISION_TIMEOUT
};

static ble_hrs_c_t        m_ble_hrs_c;                                                    /**< Main structure used by the Heart rate client module. */
static ble_rscs_c_t       m_ble_rsc_c;                                                    /**< Main structure used by the Running speed and cadence client module. */
static uint16_t           m_conn_handle_hrs_c            = BLE_CONN_HANDLE_INVALID;       /**< Connection handle for the HRS central application */
static uint16_t           m_conn_handle_rscs_c           = BLE_CONN_HANDLE_INVALID;       /**< Connection handle for the RSC central application */

static ble_db_discovery_t m_ble_db_discovery[CENTRAL_LINK_COUNT + PERIPHERAL_LINK_COUNT]; /**< list of DB structures used by the database discovery module. */

/* Peripheral related. */

#define PERIPHERAL_ADVERTISING_LED       BSP_BOARD_LED_2
#define PERIPHERAL_CONNECTED_LED         BSP_BOARD_LED_3

#define DEVICE_NAME                      "RelayNordic"                                    /**< Name of device used for advertising. */
#define MANUFACTURER_NAME                "NordicSemiconductor"                      /**< Manufacturer. Will be passed to Device Information Service. */
#define APP_ADV_INTERVAL                 300                                        /**< The advertising interval (in units of 0.625 ms). This value corresponds to 187.5 ms. */
#define APP_ADV_TIMEOUT_IN_SECONDS       180                                        /**< The advertising timeout in units of seconds. */

#define FIRST_CONN_PARAMS_UPDATE_DELAY   APP_TIMER_TICKS(5000, APP_TIMER_PRESCALER) /**< Time from initiating event (connect or start of notification) to first time sd_ble_gap_conn_param_update is called (5 seconds). */
#define NEXT_CONN_PARAMS_UPDATE_DELAY    APP_TIMER_TICKS(30000, APP_TIMER_PRESCALER)/**< Time between each call to sd_ble_gap_conn_param_update after the first call (30 seconds). */
#define MAX_CONN_PARAMS_UPDATE_COUNT     3                                          /**< Number of attempts before giving up the connection parameter negotiation. */

static ble_hrs_t    m_hrs;                                                          /**< Main structure for the Heart rate server module. */
static ble_rscs_t   m_rscs;                                                         /**< Main structure for the Running speed and cadence server module. */


/**@brief names which the central applications will scan for, and which will be advertised by the peripherals.
 *  if these are set to empty strings, the UUIDs defined below will be used
 */
static const char m_target_periph_name[] = "";

/**@brief UUIDs which the central applications will scan for if the name above is set to an empty string,
 * and which will be advertised by the peripherals.
 */
static ble_uuid_t m_adv_uuids[] = {{BLE_UUID_HEART_RATE_SERVICE,         BLE_UUID_TYPE_BLE},
                                   {BLE_UUID_RUNNING_SPEED_AND_CADENCE,  BLE_UUID_TYPE_BLE}};
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
