ubi-naist/SenStick/(commit log)

2015-12-16 テンプレートプロジェクトを追加。
2015-12-17 空ソース・ファイルを追加。
2015-12-17 アドバタイジングのパラメータを定義。
2015-12-17 Keilのプロジェクトを定義。
    [奈良先端科学技術大学プロファイル仕様書_rev1_5_0.xlsx]
2015-12-20 IOピン設定を開始。
2015-12-20 IOの設定コードを書いた。
2015-12-21 サービスを書いた。
2015-12-24 ビルド可能。
2015-12-24 アドバタイジングまでできる状態。RTTロギング可能。
2015-12-26 9軸センサの関数を追加。
2015-12-27 9軸センサーのデータ取得を確認。
2015-12-28 圧力センサー動作を確認。
2016-01-03 湿度データを追加。
2016-01-03 照度センサーを追加。
2016-01-04 フラッシュメモリのサンプルコードをdocsに追加。
2016-01-04 フラッシュのサンプルコードを取り込み。
2016-01-06 SPIフラッシュのコードを追加。テストがパスしていない。
2016-01-06 ピン名を変更。
2016-01-08 SPIの構造体を初期化。バスへのアクセスはできる。IDの値がおかしい。3バイト読み出せていない。2バイトのみ。
2016-01-09 SPIフラッシュ読み書き動作確認。
2016-01-14 ロガーを追加。
2016-01-14 ロガーのテスト関数を追加。動かない
2016-01-17 ロガー、動作を確認。
2016-01-17 twiテストコードを関数に分離。
2016-01-17 BLEのキャラクタリスティクスの接続を確認。
2016-01-17 コネクションインターバル最大値を50ミリ秒に。
2016-01-18 設定機能を実装。
2016-01-21 当初仕様のファーム、動作確認。
2016-01-21 デバイスインフォアメーションサービスを追加。SEGGER RTTのバッファメモリ量を1024から128に減らした。
2016-01-22 バッテリー監視サービスを追加。
2016-01-29 いろいろ更新。動かない途中段階。
2016-02-02 ビルドはできる。
2016-02-03 S130からS110に切り替え。メモリが不足したため。
2016-02-03 センサー値はおかしいが、TIセンサータグで動作はする。
2016-02-03 変数名などを変更。TemperatureAndHumidtyの順番を逆に。
2016-02-04 ファイル周りを作りかけ。
2016-02-06 リストをいじってみた。
2016-02-18 ロガーを追加。テストコード追加。とりあえずビルドはできる。
2016-02-19 とりあえずテストコードを追加。
2016-02-21 ログ記録部分のテストが通る。
2016-02-21 SPIの初期化をflash_streamに移動。
2016-02-23 ログサービスを追加。
2016-02-23 センサデータ構造体に種類を含めた。
2016-02-23 9軸センサのデータを、一括処理から個別扱いに変更。
2016-02-23 TIセンサータグサービスから照度のコードを削除。
2016-02-23 LEDのブリンク機能を追加。
2016-02-23 ボタンの長押し検出機能を入れた。
2016-02-24 LED点灯モードに、繰り返すか繰り返さないか、を追加。
2016-02-24 RTCの独自データ型をBLEのDateTime型に変更。
2016-02-26 ログ取得サービス周り、作りかけ。
2016-03-01 ロガーサービスをおおまかに実装。
2016-03-01 TWIのクロックを400kHzに変更。
2016-03-01 クロックソースを外部32kHzに、ソフトウェアデバイスが32kHz xtal利用設定に。
2016-03-02 意味が無いログをコメントアウト。
2016-03-02 センサデータの処理ミスを修正。
2016-03-02 IR温度計のサービスを削除。TIのアプリはサービスがなくても動く。
2016-03-02 加速度の処理ミスを修正。
2016-03-03 ジャイロおよび磁場センサーのTI互換GATT周りを修正。
2016-03-03 TI互換GATTサーバから、バロメータを削除。換算式似合わせるのが面倒だったので。
2016-03-03 磁場センサーの資料を追加。
2016-03-03 サービス構築部分をライブラリを使うようにした。
2016-03-03 ロガーGATTサービスの読み書き属性設定漏れを追加。
2016-03-04 外部基板センサーがなくても動作するように。
2016-03-07 構造体のコピーを、memcpyを呼び出すものから、代入に変更。アセンブラコードは内部でmemcpyしている。
2016-03-07 センサー設定情報を、sensormanagerクラスに持たせるようにした。
2016-03-12 ログ周りをいじる。
2016-03-15 iOSの空プロジェクトを追加。
2016-03-17 SDK作り始め。
2016-04-09 とりあえず
2016-04-26 iOS SDK、とりあえずビルドはできる。
2016-04-27 動作確認iOSアプリ、デバイスリストまで。
2016-05-17 とりあえず。
2016-05-21 ビルドは可能。
2016-05-21 ベリーアルファ。
2016-05-22 デバイスリスト表示を実装。
2016-05-23 デバイスステータス表示の実装。
2016-05-23 センサログの取得(コンソール)。
2016-05-23 各種センサを追加。
2016-05-23 バッテリ値取得を実装。
2016-05-24 ジャイロと地磁気センサーを、アプリに実装。
2016-05-24 照度センサーをアプリに実装。
2016-05-24 湿度センサーをアプリに追加。
2016-05-24 気圧センサーをアプリに実装。
2016-05-25 センサリスト表示テーブル部分を組み直し。
2016-05-25 グラフ表示をアプリに実装。
2016-05-25 各種センサのセルを実装。
2016-05-25 アプリにファイル保存を実装。
2016-05-26 ログの数取得、キーボードの表示不具合修正。切断時にリストに戻る機能実装。
2016-05-26 照度センサーの検出不具合、ファームウェア修正。
2016-05-26 ボタンのモジュールを、ファームウェアに実装。
2016-05-26 定義ファイル名を変更。TWIデバイスを起動時に電源OFF/ONするように。
2016-05-26 ログのメタデータ書き込みの致命的なバグを修正。
2016-05-26 強制電源リセット時のディスク保護機能を追加。
2016-05-26 ヘッダ数の上限到達検出を追加。
2016-05-26 電圧低下によるDeepSleep遷移を実装
2016-05-26 ボタンによるスリープ機能とLED表示を実装。
2016-05-26 アドバタイジング周期を0.1/1秒に。アイドル状態にならぬようにした。
2016-05-26 ボタンを押したらログ開始、電源ONでログ開始。
2016-05-27 データ取りこぼしのバグ修正。
2016-05-27 BLE電源オフによるデバイスリストのクリアと、UIへの反映。
2016-05-27 データ点が多い場合の描画処理を抑えるために、データ更新通知頻度を0.3秒に。
2016-05-27 通知の間引きでUI描画が欠けるので、なし。
2016-05-27 ディスクステータスフラグをBLEとアプリに実装。service_utilがnotifではなくindicationだったので、コードをnotifcationを使うものに差し替え。
2016-05-27 無効なセンサーのBLEのサービスもそのままに。ハードエラーでiOS側のBLEのキャッシュ不整合が起きるのを避けるため。
2016-05-27 センサーが不能時の挙動に対応。settingがアプリ側で取れない。BLEのバグ?
2016-05-27 秋季都レンジ設定機能をアプリに実装。
2016-05-28 ログ読み出しの画面描画を、データ取り出し終了時にした。画面描画処理に時間を取られてデータ取りこぼす。
2016-05-28 ファーム側にサンプリング周期の受け入れ制限を実装。
2016-05-28 ジャイロのレンジ設定バグを修正。
2016-05-28 グラフ表示の上下反転バグ。ファームの型のミスで下位1バイトのみ送っていたバグ修正。
2016-05-28 動作有効なセンサーがない場合は、動作スタートをさせない。
2016-05-28 センサ再起動時に初回データ読み捨て。
2016-05-28 bootloaderテンプレートを追加。
2016-05-28 カスタムボードを追加。
2016-05-28 ボタンによるDFUアップデートを除外。
2016-05-28 ブートローダのメモリ配置を変更、デバッグ可能にするために。
2016-05-28 既存ブートローダを持ってきた。
2016-05-29 クロックソースを32MHzにしたら動いたorz
2016-05-29 クロックソースを32MHzに。
2016-05-29 ブートローダのデバイス名を変更。
2016-05-29 DFU遷移コードを入れた。メモ8kBだから無理やり。
2016-05-29 LED点灯のタイマーを常に動かすものにした。ワンショットの連続だと処理が間に合わずスケジューラがあふれる。
2016-05-29 湿度センサーの値処理のバグを修正。
2016-05-29 ブートローダの山椒粉ウードを削除。
2016-05-29 rev1.00 バイナリを追加。
2016-05-29 gatt仕様書をdocs/に移動。
2016-05-30 使い方ドキュメントを追加
2016-05-30 ログデータ読み出しの過度のデリゲート読み出しを避ける実装。
2016-05-30 Main.storyboardの無駄なVCを削除。
2016-05-30 デバイス画面からデバイスリスト表示に戻るときにBLE接続を切る。
2016-05-30 デバイスリスト表示からデバイス画面に遷移するときに、デバイス接続するように実装。
2016-05-31 ログ表示部分を書き換え。リアルタイムデータの表示はできる。ログ取得は動かない。
2016-05-31 ログ取得とそのグラフ表示。
2016-05-31 バイナリファイルの履歴ファイルと、ソフトウェアデバイスのHEXファイルを置いた。
2016-06-01 ログメタデータの日時読み出しで、存在しないログIDが指定された時、時刻の値をすべて0にするようにコード変更。
2016-06-02 ドキュメントを追加。
2016-06-02 リリース用プロジェクトアイテムを追加。
2016-06-02 [バグ]ロギング中のログ読み出しでファームの例外発生。
2016-06-02 センササービスのメタデータ読み出しの解説漏れを追加。
2016-06-02 照度、UVのサンプリング周期を最小300ミリ秒とするiOSアプリ側の追加。
2016-06-04 ファームウェア1.01を追加。パナ向けファームウェアを追加。
2016-06-04 iOSアプリからのストレージフォーマットボタンを追加。
2016-06-04 iOSアプリ。接続したことのあるデバイスはリストに入れない。アドバタイジングしているもののみ、リスト化。
2016-06-04 パナ向けDFUイメージファイルを追加。iOSアプリのデバイスリスト更新、ミスっていので修正。
2016-06-07 配信用にAdHocのプロビジョニングにUUIDを追加。再ビルド。
2016-06-11 DeviceInformationServiceを追加。
2016-06-11 BatteryServiceを追加。
2016-06-11 センサ周期のキーボードをDecimalキーボードに。Doneボタンをツールバー表示するように。
2016-06-11 DFUライブラリをCocoapodでインストール。
2016-06-13 デバイス情報表示を追加。
2016-06-22 iOSアプリにDFU機能を実装。
2016-06-22 ファームウェア、デバイスのシリアル番号をDeviceInformationServiceに追加。
2016-06-23 ファームウェアにデバイス名の変更機能を実装。
2016-06-26 iOSアプリにデバイス名の変更機能、ログ表示及び保存周りの修正。
2016-06-26 ファームウェアのバグ修正。終端パケットが送られない場合があった。
2016-06-26 iOSアプリ。ログ保存部分修正。
2016-06-27 ログの時刻取得のバグを修正。
2016-06-27 バグ修正。ログダウンロードでボタンを押したら反応するのを修正。
2016-07-04 ビルド方法のREADMEを追加。
2016-07-04 4インチデバイスでの表示崩れを修正。
2016-07-11 コールグラフとスタック情報の出力オプションを、MKD-ARMのプロジェクトファイルに追加。
2016-08-03 パナソニック向けプロジェクト設定を追加。
2016-08-04 デバイス仕様書のPDFファイルを追加。
2016-08-06 ライセンスファイル(MIT)を追加。
2016-08-24 - センサ周期20ミリ秒化。 - ファームのサンプリング周期のデフォルト値を、300ミリ秒から200ミリ秒に変更。 - ファームのリビジョンを上げる。1.02 -> 1.03。
    ファーム実装:
    - センサ取得をTIMER2割り込みに。ログ吐き出しはスケジューラで実行。
    - センサデータをメイルボックス経由に。
    iOS実装:
    - SDK側で、UVなどのサンプリング周期を300ミリ秒以上に制約していたのを除去。
2016-08-24 Podsをアップデート。
2016-08-24 ファームウェアrev1.03のイメージを追加。Xcodeにファームを登録。
2016-08-24 PagesのドキュメントをPDFに吐き出した。
2016-08-26 部品リストおよびnRF52版更新メモを追加。SenStickドキュメントに、デバイスの設計概念を追記。
2016-08-29 README.mdを追加。
2016-08-29 Add 3D Case Data Directory
2016-08-29 Add basic case data
    [body_for_basic_non_log.stl, button.stl, cover_for_basic.stl]
2016-08-29 Add some 3D case data
    [base_for_ring.stl, body_for_basic_non_log.stl, body_for_chopstick.stl, body_for_flat.stl, body_for_ring.stl, body_for_strap.stl, body_for_super_flat.stl, button.stl]
2016-08-29 バグ修正。デバイス名の変更がアドバタイジングに反映されるように修正。
2016-08-29 SDK, アドバタイジングのローカルネームをデバイス名に反映する修正。
2016-08-30 Windowsで不具合の出るファイル名を修正。
2016-08-30 Add 3D data of some cases and one of curcuit bord for senstick2
    [base_for_ring.stl, body_for_basic_non_log.stl, body_for_chopstick.stl, body_for_flat.stl, body_for_ring.stl, body_for_strap.stl, body_for_super_flat.stl, button.stl]
2016-08-30 Add README.pdf for 3D case data
2016-08-30 Add README.pdf for case of glasses
2016-08-30 ロゴダウンロード部分、リファクタリング。
2016-08-30 [bugfix]ログ読み出し時に、ログの周期読み出し処理を書いていなかった。現在の周期を設定していた。
2016-08-31 ログデータの保存処理文を、継承元のクラスに移した。
2016-08-31 ログ保存終了デリゲートを実装。ログ保存ViewControllerにログ保存通知を集約させる。
2016-08-31 デバイス名のフォルダ以下にデータを保存するようにした。
2016-09-01 ログ出力ファイルを、センサを統合したファイルを出力するように。
2016-09-01 ファームウェアのaxfファイルを追加。
2016-09-01 rev1.04 iOSおよびファームを更新。
2016-09-01 DS_Storeを削除。
2016-09-02 データフルの振る舞いを実装。
2016-09-03 データ末尾到達時処理のバグ修正。ストレージ比率を変更。20ミリ秒記録に対応した容量割り振り。
2016-09-03 [bugfix]センサログ読み出し中のセンサログ取得開始時のファーム落ちを修正。
2016-09-25 Podsを除去。
2016-09-25 サブモジュールとしてZip, iOSDFULibrary をクローンした。
2016-09-25 SDKのプロジェクト設定で、ライブラリ依存性を追加。
2016-09-26 SDKをSwift3に自動変換。
2016-09-26 SDKのSwift3対応。iOS10以降サポート。
2016-09-27 SenStickViewerのSwift3対応。
2016-10-10 enum 命名をlowerCamelに。
2016-10-10 Cocoapodsを利用。
2016-10-11 Cocoapods対応。
2016-10-11 Podspecファイルを編集。
2016-10-11 READMe.mdにpodのインストール方法を記述。
2016-10-11 README.mdの些細な修正。
2016-10-12 リファクタリング。
2016-10-13 nrf51 keilプロジェクトディレクトリ名を変更。
2016-10-13 nRF5 SDK12を追加。
    [config.txt]
2016-10-14 ファームウェアのフォルダ名構成をnRF51/52で分離変更。
    [奈良先端科学技術大学プロファイル仕様書_rev1_5_0.xlsx]
2016-11-21 ビルド番号を+1。
2016-11-29 nRF52向け、ビルドは可能。動作未確認。
    [config.txt]
2016-12-03 BLE接続可能。ファームは動作。GATTサーバへの接続処理が進まない。
    [config.txt]
2016-12-03 プロジェクトのリンカ設定、メモリ配置を変更。GATTSでテーブルサイズ増量のため。
2016-12-04 sdk_config.hの設定を、差分をapp_config.hに、sdk_config.hはテンプレートそのままに、分離。
2016-12-05 TWIのバグ修正。PINRESETの削除。
2016-12-25 [バグ]iTunes共有ファイルの設定が消えていた。Info.plistに設定を追加。
2016-12-25 bootloaderをnrf51用フォルダに変名。
2016-12-25 nRF52ブートローダ、サンプルプロジェクトをコピー。
2016-12-25 nRF52ブートローダのフォルダ名を変更。
2016-12-25 nRF52ブートローダ、プロジェクトフォルダを移動。pb protoファイルをprotocol bufferのコンパイラにかけた。
2016-12-26 nRF52ブートローダdebug版、ビルド可能。
2016-12-26 S132をver3に、SDK12を12.2に更新。
2016-12-26 更新したSDK似合わせてmicro_eccをビルド。
2016-12-26 SDKのサンプルプロジェクトでbootloader_s132を更新。
2016-12-26 DFU S132プロジェクトdebug、ビルド確認。
2016-12-26 S132ブートローダ リリースプロジェクトのビルド可能。
2016-12-26 無駄なボード定義ファイルを削除。
2016-12-26 nRF52ブートローダおよびパッケージのビルド確認。
2017-01-10 nRF52ブートローダおよびファームからのDFU切り替えを実装。
2017-01-16 サブミットのためアプリバージョンを1.06に設定。
2017-01-17 ファームウェアバージョンを1.0.6に設定した。
2017-01-17 nRF51プロジェクトをビルド可能にした。
2017-01-18 nRF52のRTCを実装。
2017-01-18 nRF51/nRF52両方のRTCを、nRF5のRTC利用に揃えた。
2017-01-18 電池残量の計算係数を訂正。3.2-4.2Vで 0-100%表示になることを確認。
2017-01-19 デバイスのスリープ状態に入るコマンド列挙型の表記名を、enterDeepSleepからshouldDeviceSleepに変更。
2017-01-22 TWIのデバッグメッセージを追加。 TWIのバスを専有する処理を、タイマーから複数回呼び出しにより、処理を止めない内部ステートマシン処理に置換。 タイマーの例外で数秒で止まるバグがある。
2017-01-23 センサ周期10ミリ秒での取得。バグ原因はフラッシュ処理完了待ちの遅延時間を大きく取りすぎていたこと。
2017-01-23 コンパイル時WARNINGへの修正。使用していない変数の削除。
2017-01-23 ログカレンダー日時がiOSアプリで正しく表示されないバグを修正。SDKのバージョンを1.03にあげた。
2017-01-23 [bug]スリープ時に消費電流が700uAになる。TWIをdisable/uninitしていなかったため。
2017-01-24 - iOSアプリのDFUバグ修正。DFUモードに入るコマンドの書き込み完了前にBLE接続を切断していたため、DFUモードに入らない場合があった。 - iOSDFULibraryを更新。 - iOSアプリをnRF52のSenStickのファーム更新に対応。 - nRF52 SenStickのブートローダーおよびファームウェアを作成。rev 1.06
    [ble_stack.c, main.c]
2017-01-26 nRF51版対応。センサ周期は最小30ミリ秒にした。
2017-01-29 nRF51向けプロジェクトファイルを、ビルド可能なものに更新。
2017-01-29 iOS SDK、DispatchQueueのイニシャライザを、シリアルキューを明示するものに変更。
2017-01-29 ログ取得せずセンサー動作のみの場合にメタデータが残るバグを修正。
2017-01-30 バグ修正:BLEイベントがスケジューラを使わない設定になっていたのを修正。nRF51版、LFCLKに内蔵RCを利用、外部RTCは使わない。
2017-01-31 ファームウェアのバイナリを作成。rev1.07
2017-02-01 ドキュメントを更新。
    [Senstick3_BOM_R00.xlsx, 奈良先端科学技術大学プロファイル仕様書_rev1_5_0.xlsx]
2017-02-01 何故か削除していたpodspecファイルを復活させた。
2017-02-25 I2C拡張機能を追加。モータ駆動回路。
2017-02-25 TWI拡張機能をnR52のみでビルド有効になるようにした。
2017-02-26 スリープモードの電流削減。
2017-02-26 デバイスのデフォルト名をSenStickにした。
2017-02-26 非接続時のスリープした時のアドバタイジング停止していないバグ修正。
2017-02-27 スリープ状態からの再起動時に、フラッシュがスリープして応答しないバグを修正。
2017-03-01 nRF51ファームウェア、スリープ時のTWIのプルアップを無効化。漏れ電流の削減。1.08のバイナリを生成。
2017-03-02 Basic Case for SenStick3
    Matildeから発売されたSenStick3用のケースデータです。stlファイル形式です。
    [basic_case_for_senstick3.stl]
2017-03-04 iOSアプリのアイコンを、ストアアイコンと同じものに差し替えた。
2017-03-11 Cocoapods 1.2.1.beta.1でSenStickVeriwerがビルドできるように、Podsを更新した。
2017-03-11 SenStickViewerをiOS9対応にした。
2017-03-16 SenStickの使い方のドキュメントに、ファーム更新時の異常発生時の対処方法を追記。
2017-03-22 .gitignoreにDS_Storeを追加。
2017-03-22 データファイルのタブを削除。
2017-05-19 swift fix:ジェネリック関数のoverrideでoverrideされていないというコンパイルエラーを解消。class Some<S,T>をSome<T, S>にすると、なぜか解消した...
2017-05-19 misc: 些細なコンパイルのワーニングを解消。M_PIの表現置換。エラークラスのインスタンス表示で、nilの場合があるからStringでラッピングする。の2点。
2017-05-19 bug fix: レンジ表示が不要のセンサーの設定画面に、レンジラベルが表示されたままになっていた。非表示にした。
2017-07-21 モータ駆動のステータスUUID設定ミスを修正。
2017-09-07 多言語対応
    日英対応
2017-09-07 多言語（追加修正）
    照度、ログ読み出し、の英語
2017-12-09 データファイルの行頭の時刻を、1970年を基準としたミリ秒にした。
